damnitzhemanth-oss/Flight_Controller/images/DRAFT/S1_1.png

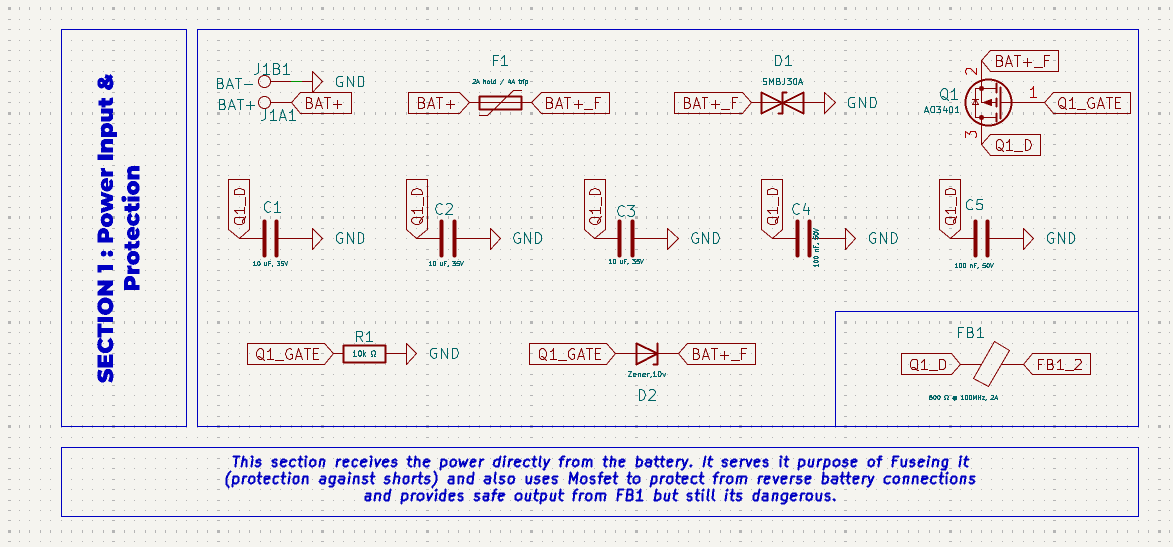
images/DRAFT/S1_1.png
