damnitzhemanth-oss/Flight_Controller/images/DRAFT/S2_1.png

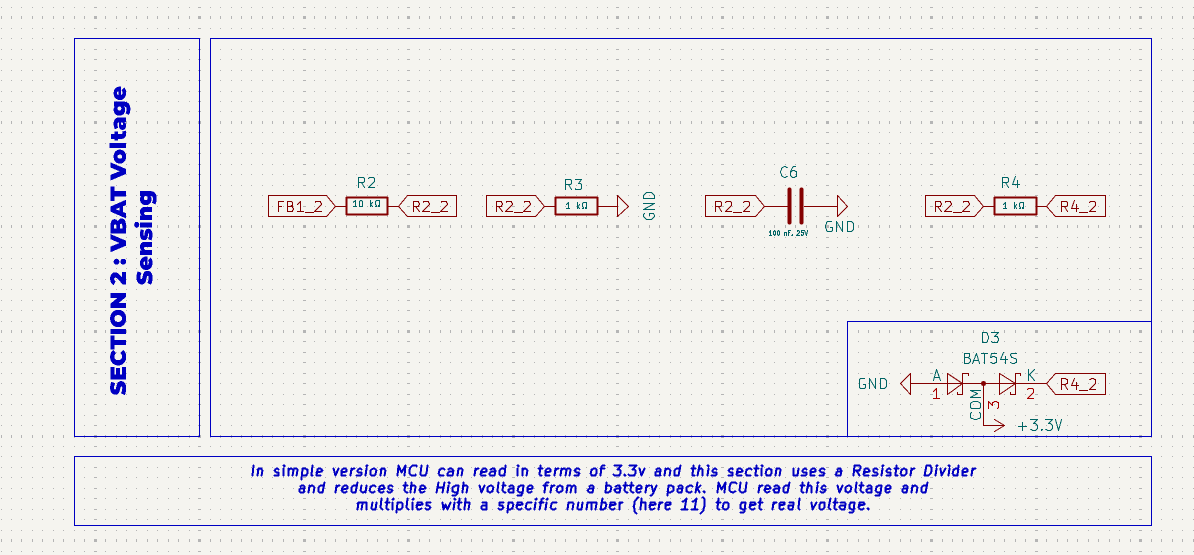
images/DRAFT/S2_1.png
