damnitzhemanth-oss/Flight_Controller/images/DRAFT/S3_1.png

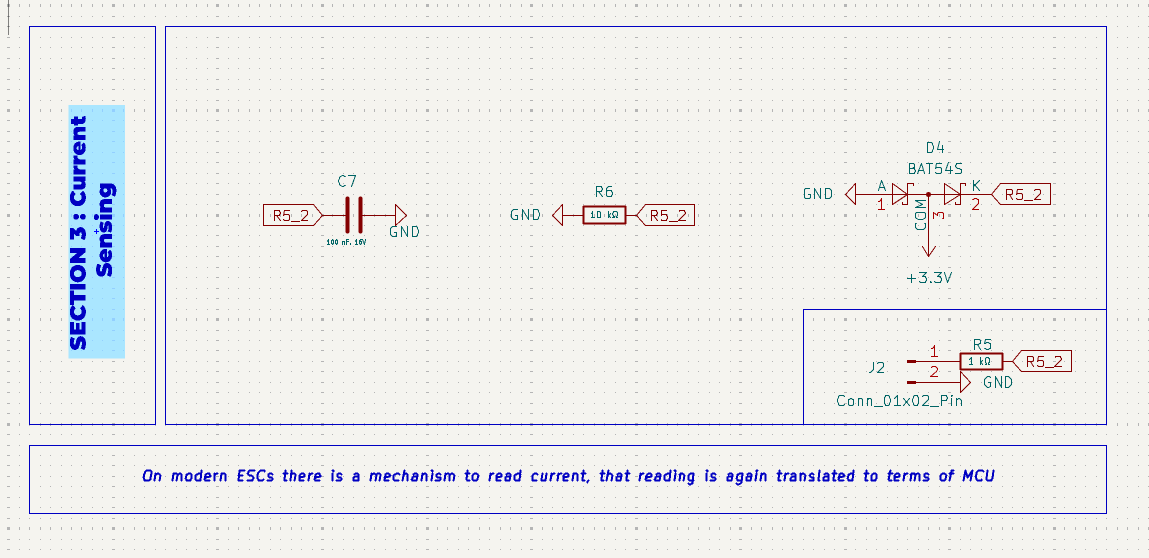
images/DRAFT/S3_1.png
