damnitzhemanth-oss/Flight_Controller/images/DRAFT/S4_2.png

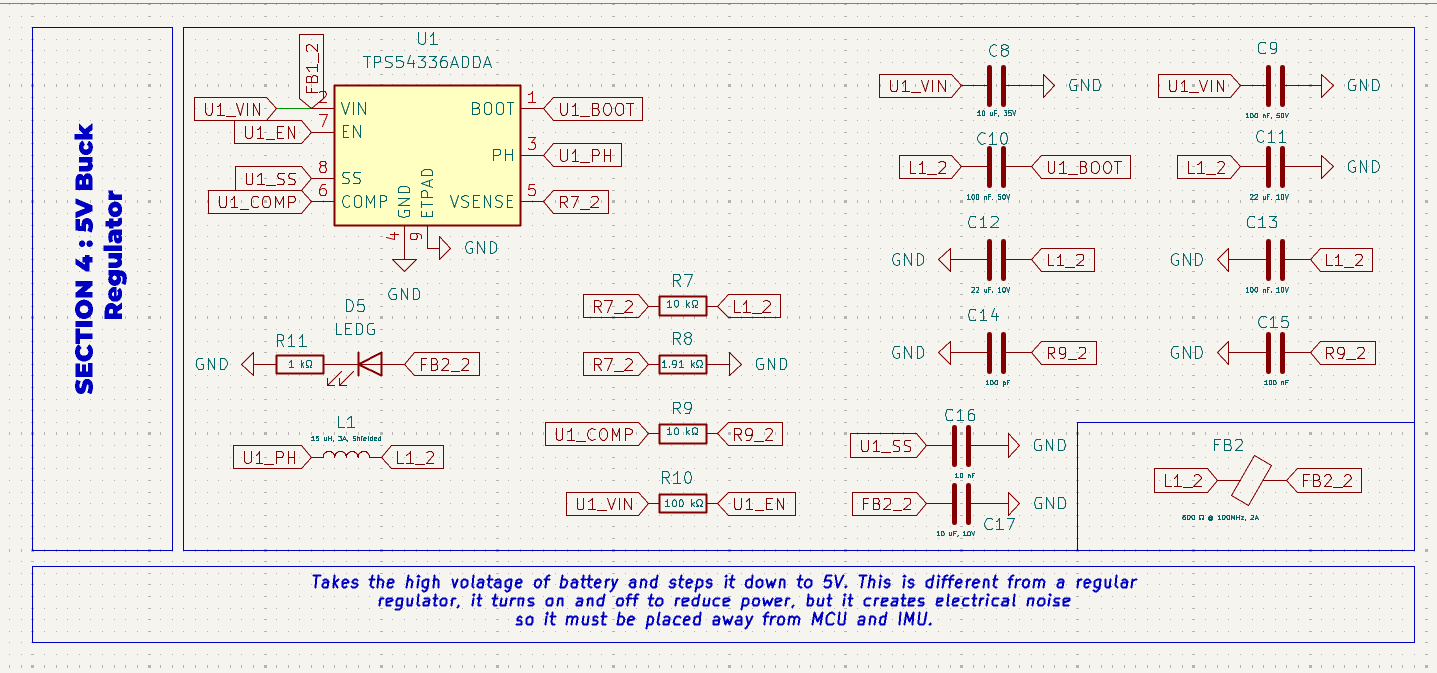
images/DRAFT/S4_2.png
