damnitzhemanth-oss/Flight_Controller/images/DRAFT/S4_P.png

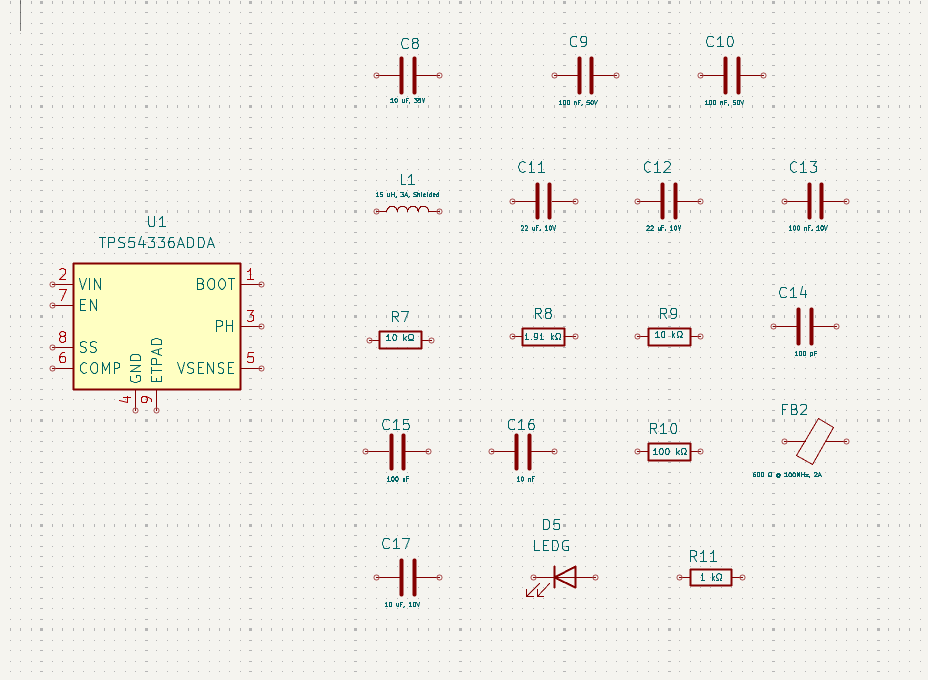
images/DRAFT/S4_P.png
