damnitzhemanth-oss/Flight_Controller/images/DRAFT/S5_2.png

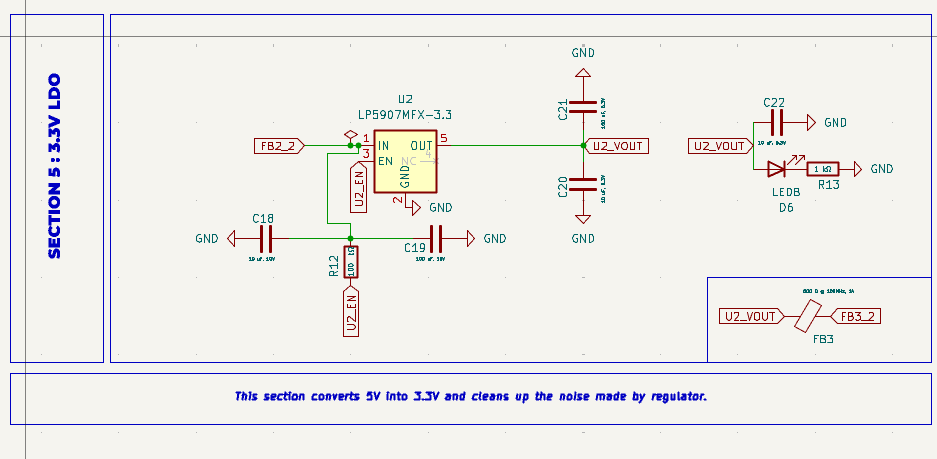
images/DRAFT/S5_2.png
