damnitzhemanth-oss/Flight_Controller/images/DRAFT/S6_2.png

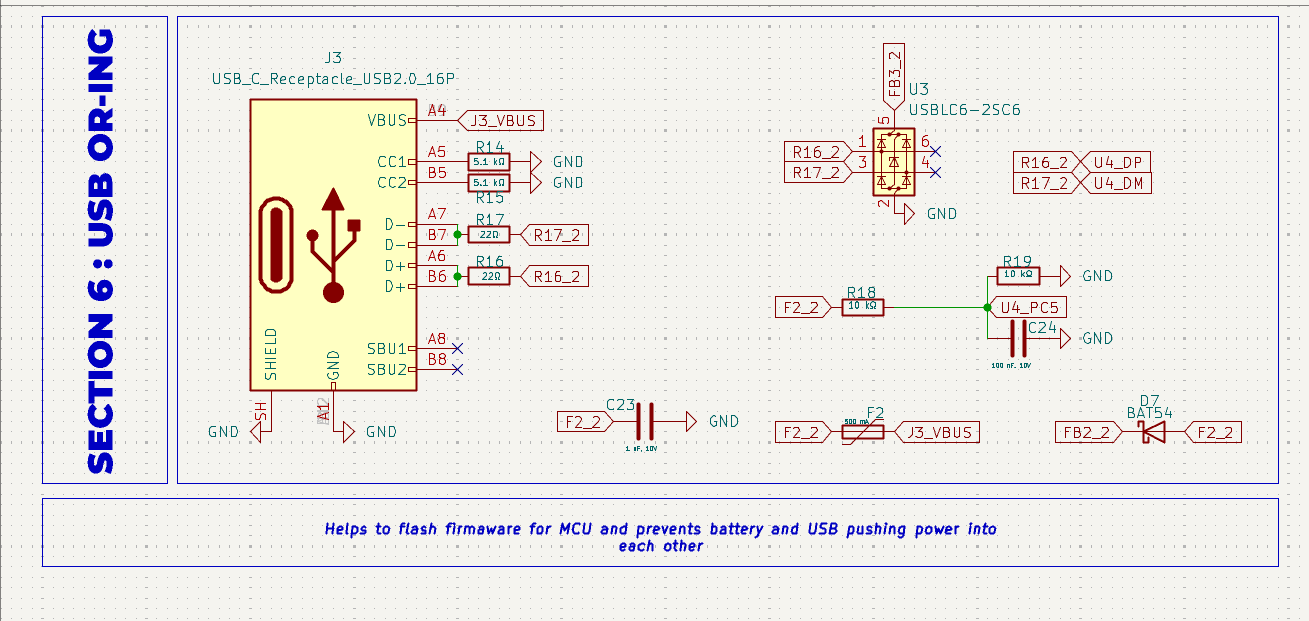
images/DRAFT/S6_2.png
