damnitzhemanth-oss/Flight_Controller/images/DRAFT/S7_2.png

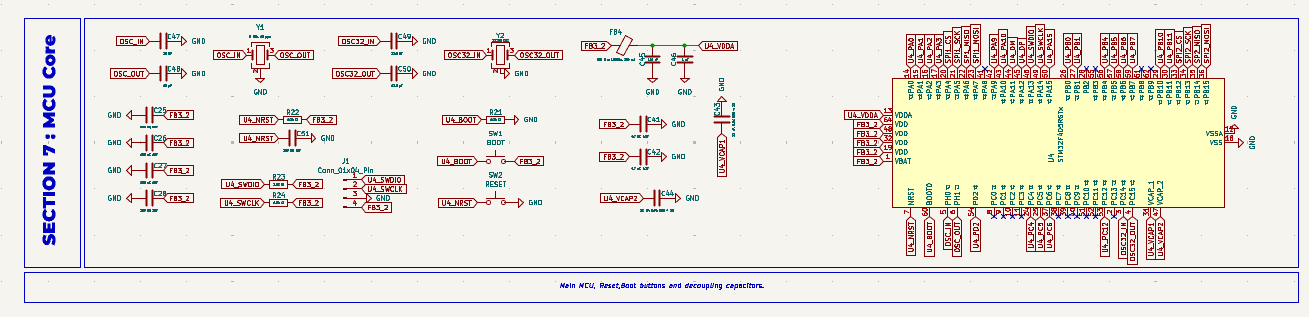
images/DRAFT/S7_2.png
