damnitzhemanth-oss/Flight_Controller/images/DRAFT/S8_2.png

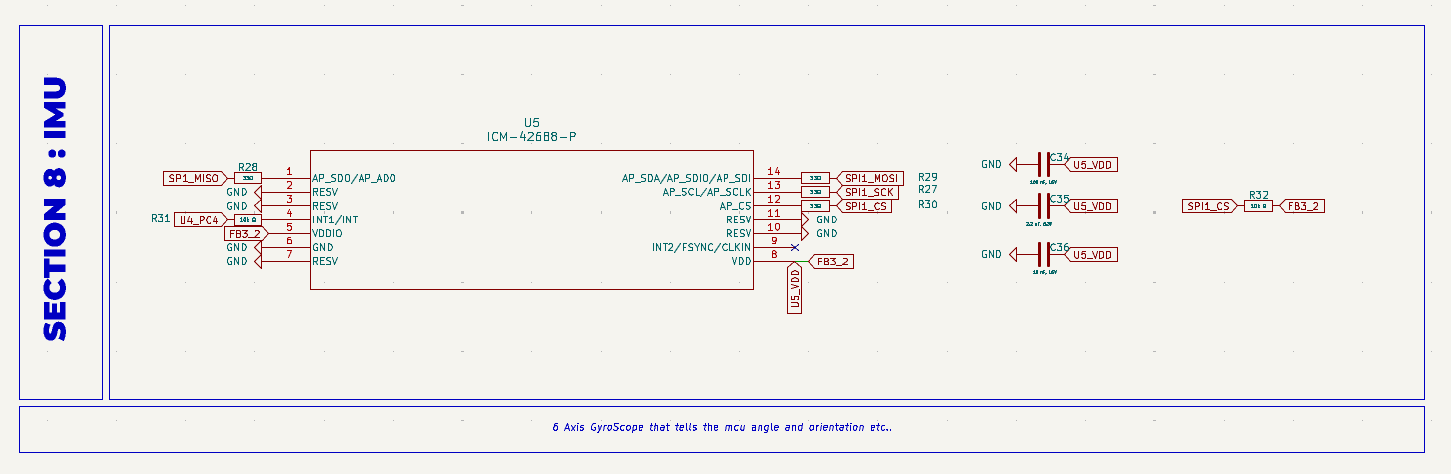
images/DRAFT/S8_2.png
