damnitzhemanth-oss/Flight_Controller/images/DRAFT/S9_2.png

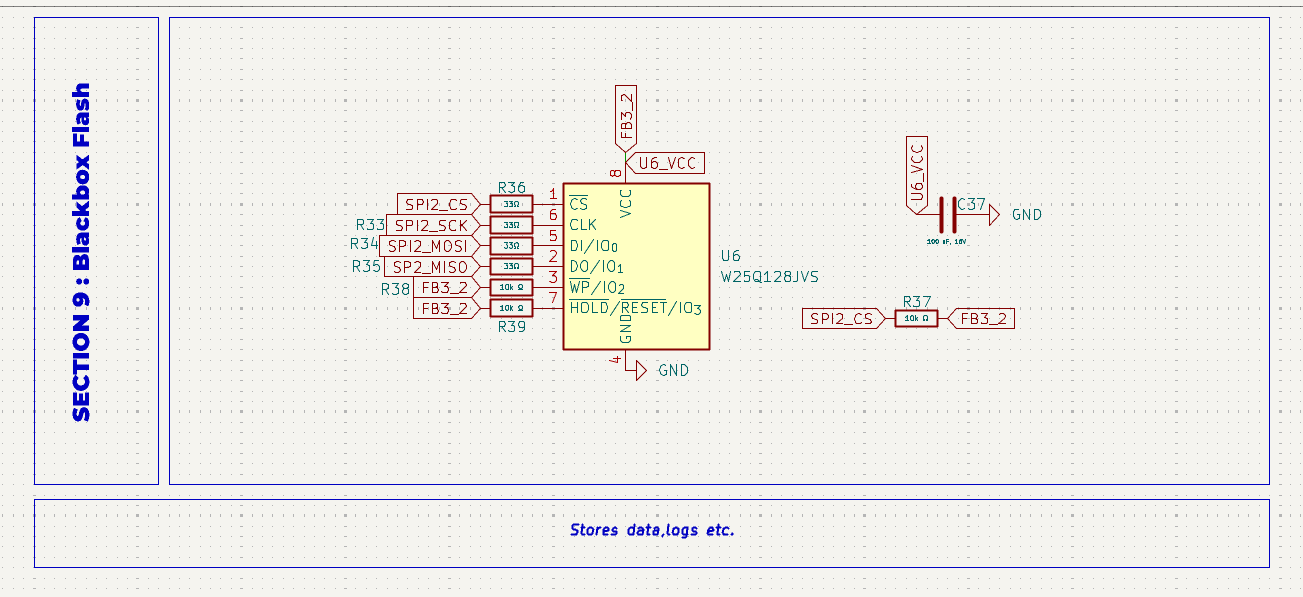
images/DRAFT/S9_2.png
