damnitzhemanth-oss/Flight_Controller/images/DRAFT/S10_2.png

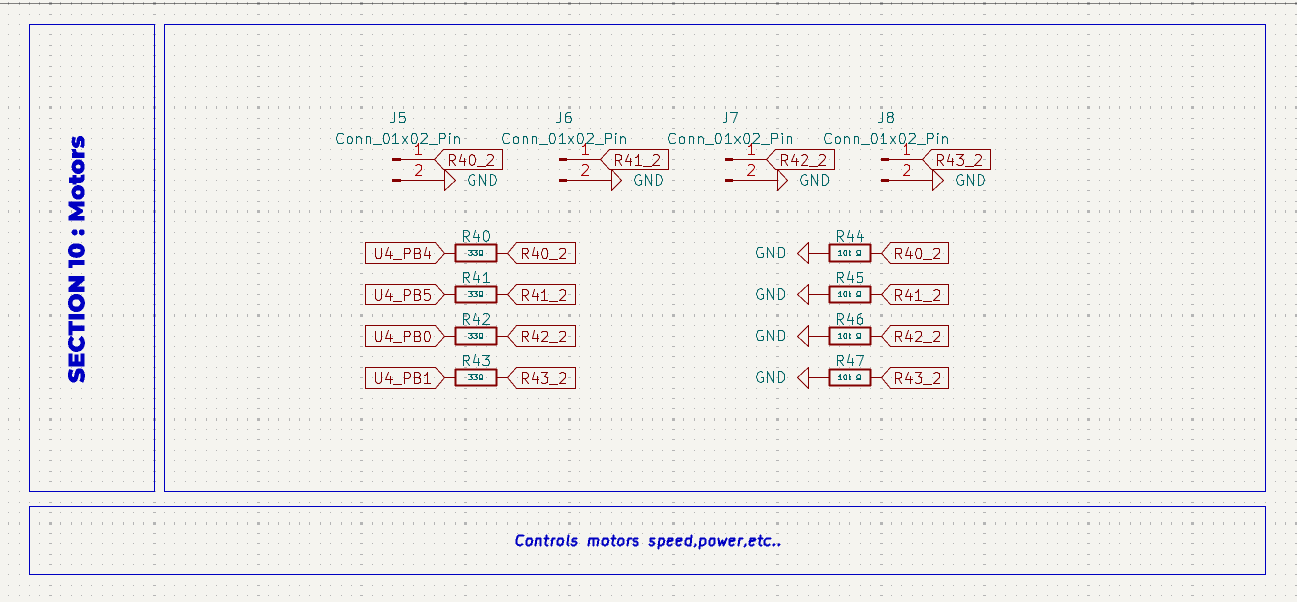
images/DRAFT/S10_2.png
