damnitzhemanth-oss/Flight_Controller/images/DRAFT/S11_2.png

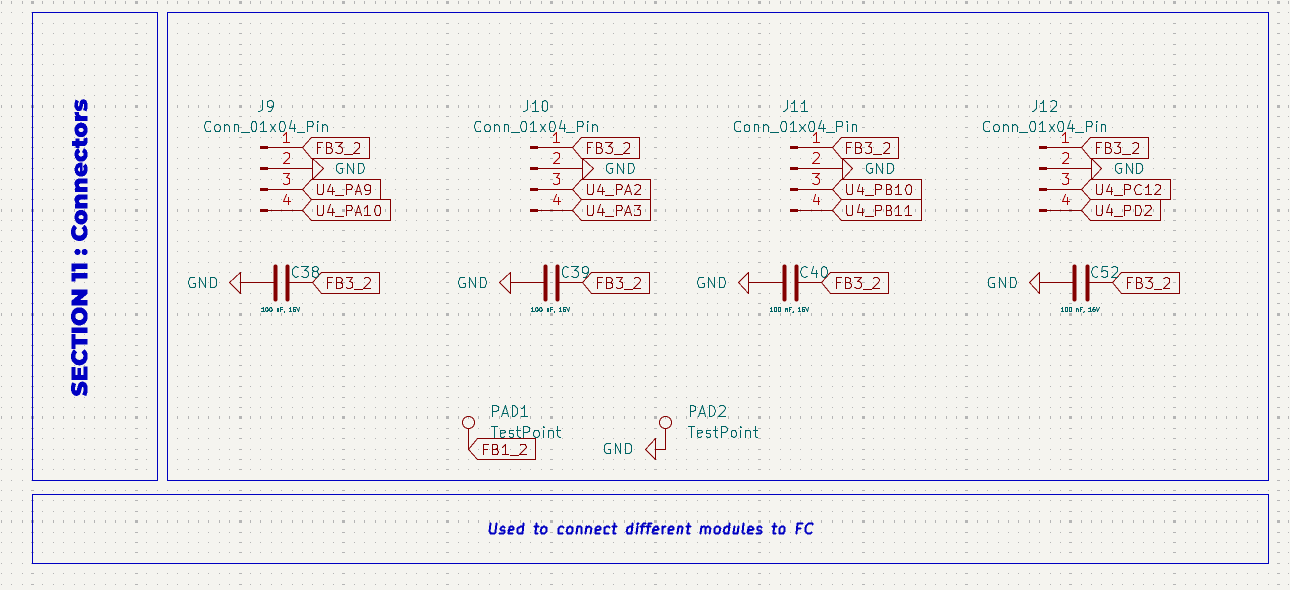
images/DRAFT/S11_2.png
