damnitzhemanth-oss/Flight_Controller/images/DRAFT/S12_2.png

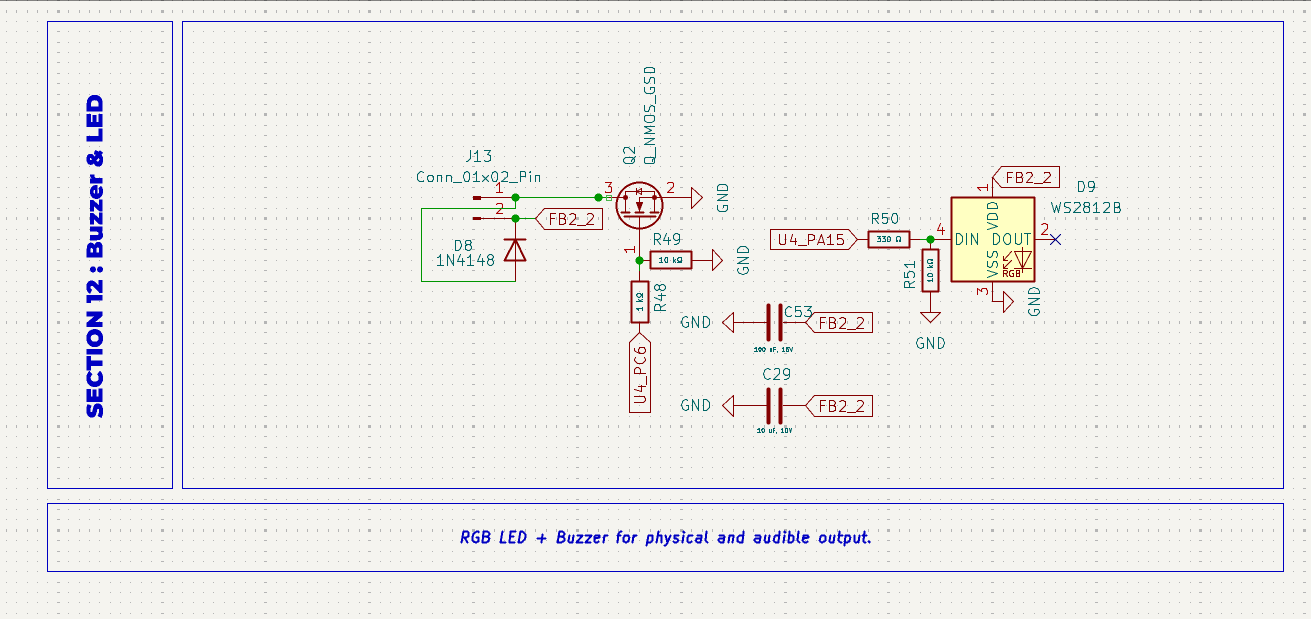
images/DRAFT/S12_2.png
