damnitzhemanth-oss/Flight_Controller/images/DRAFT/S13_2.png

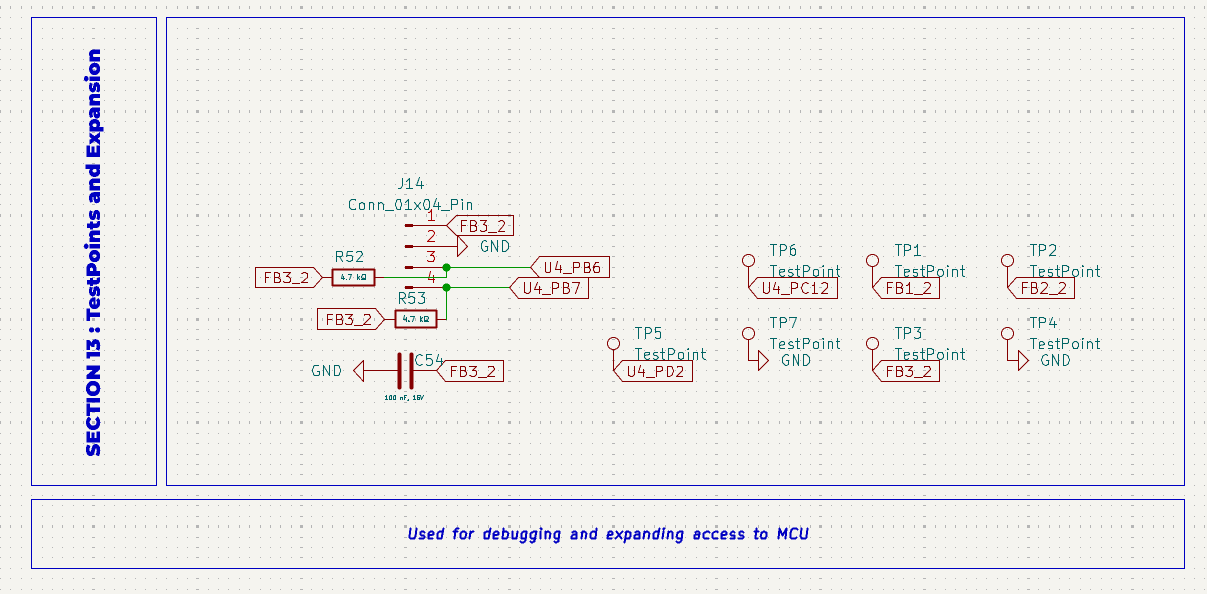
images/DRAFT/S13_2.png
