damnitzhemanth-oss/Flight_Controller/images/DRAFT/SFull_2.png

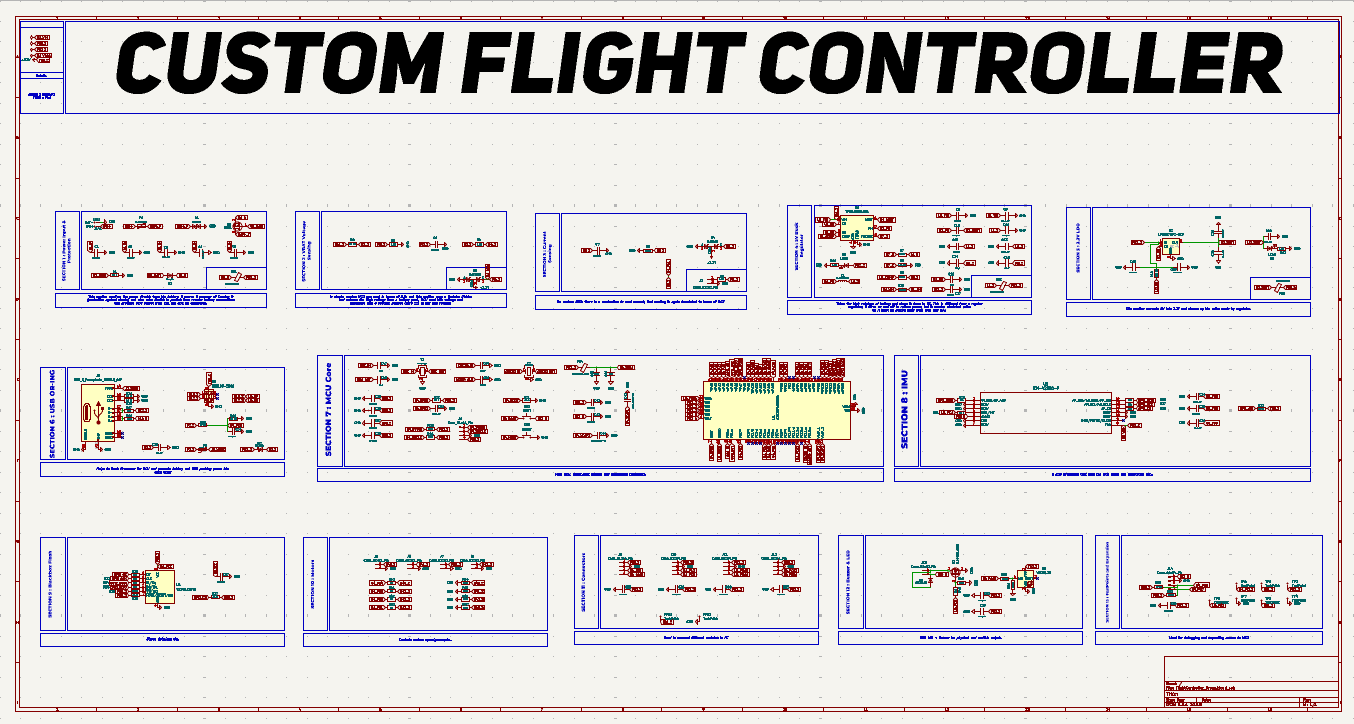
images/DRAFT/SFull_2.png
