damnitzhemanth-oss/Flight_Controller/images/FINAL/DRC_DUMB.png

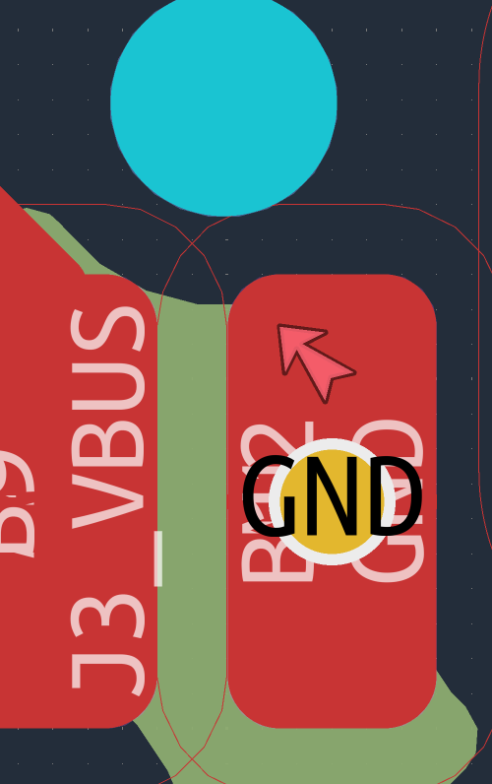
images/FINAL/DRC_DUMB.png
