damnitzhemanth-oss/Flight_Controller/images/FINAL/F_PCB.png

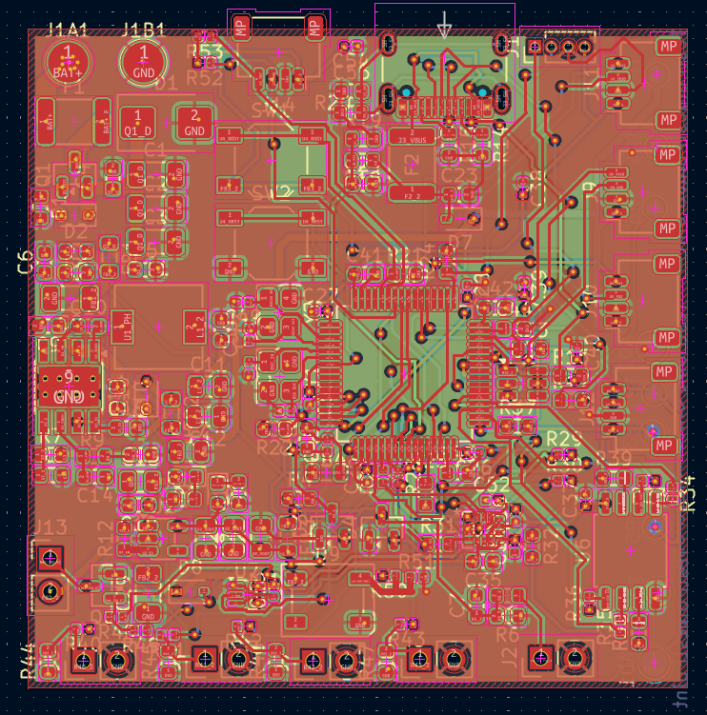
images/FINAL/F_PCB.png
