damnitzhemanth-oss/Flight_Controller/images/FINAL/In1_CU.png

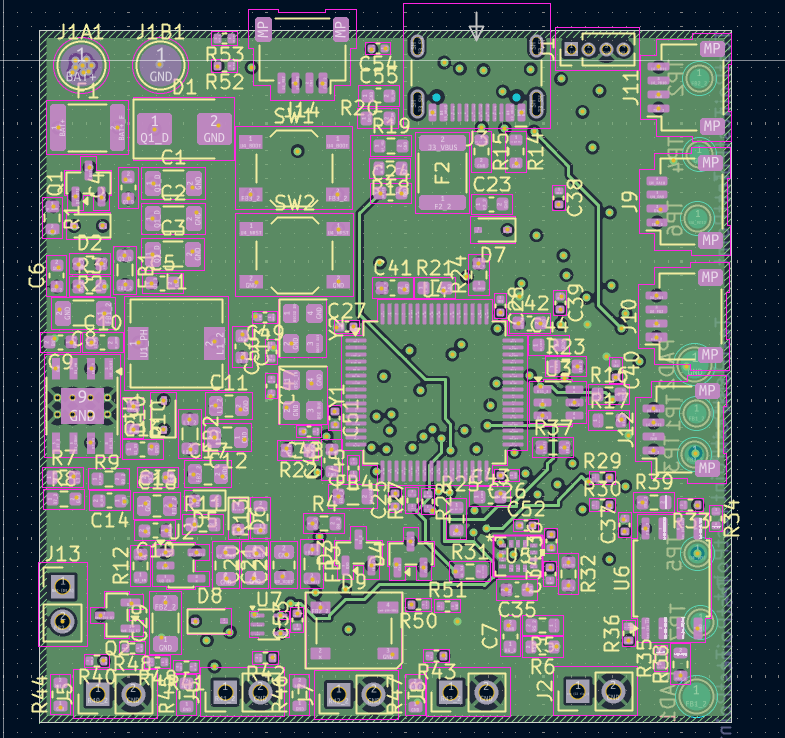
images/FINAL/In1_CU.png
