damnitzhemanth-oss/Flight_Controller/images/FINAL/In2_CU.png

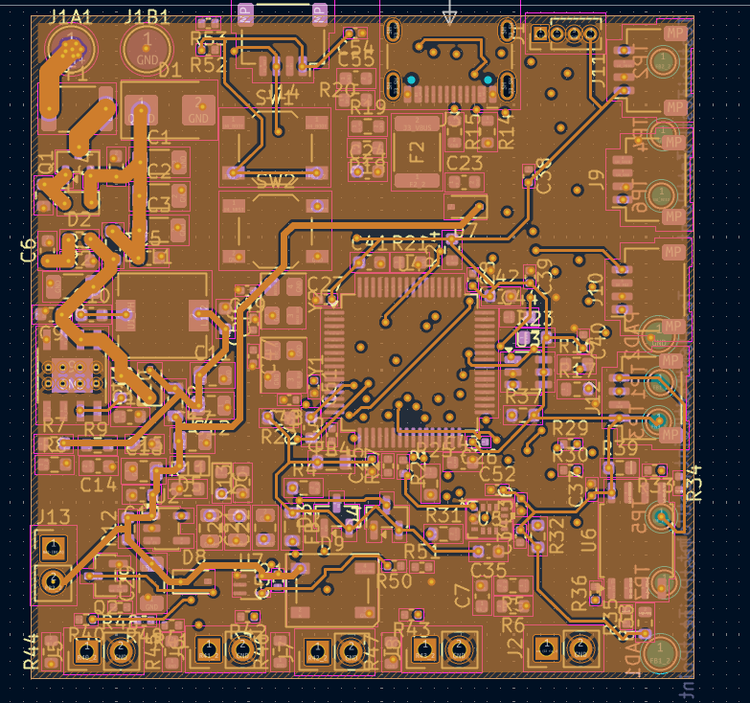
images/FINAL/In2_CU.png
