damnitzhemanth-oss/Flight_Controller/images/FINAL/S1.png

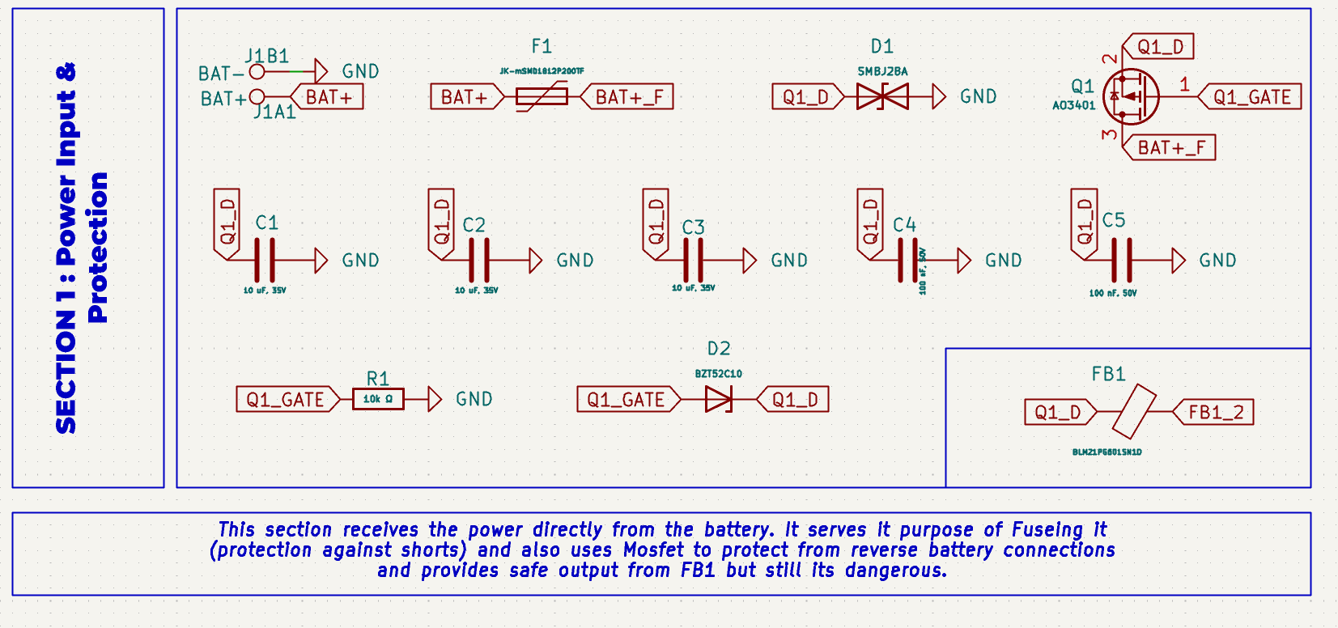
images/FINAL/S1.png
