damnitzhemanth-oss/Flight_Controller/images/FINAL/S2.png

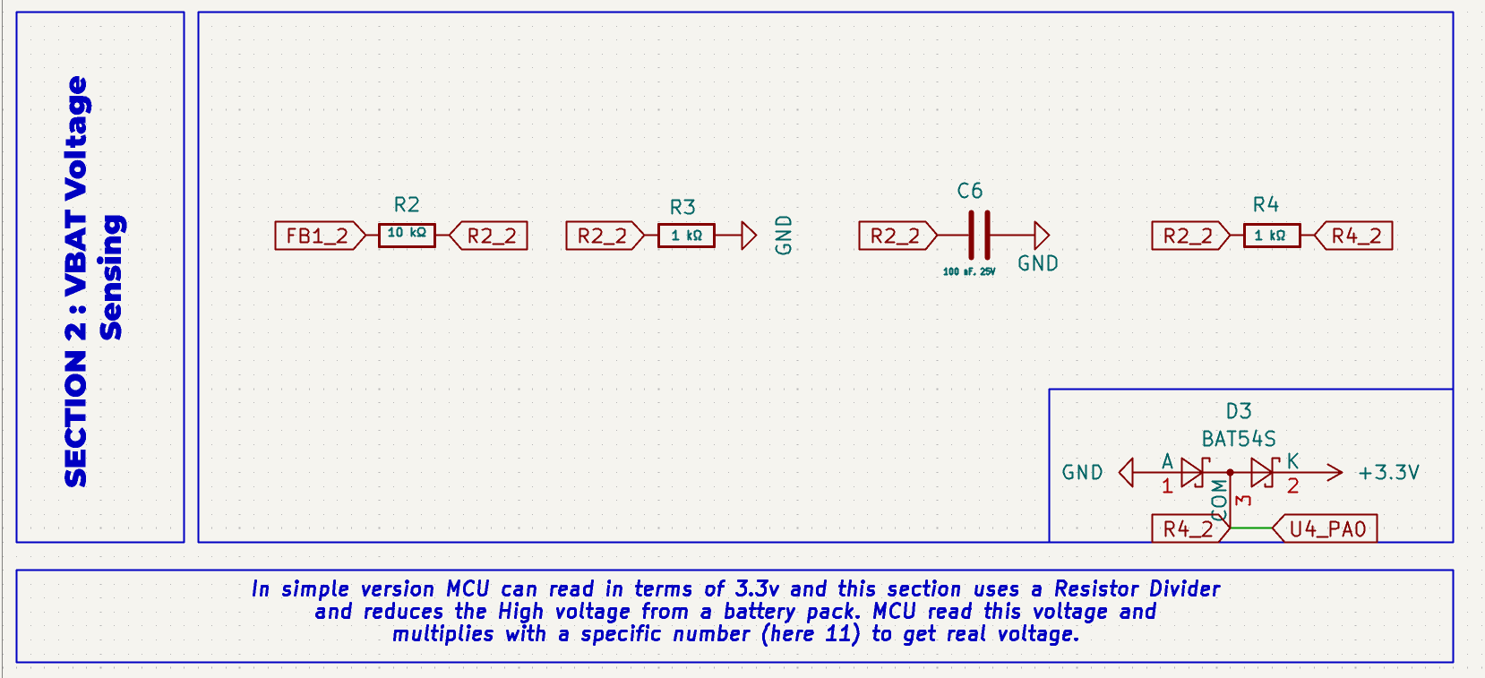
images/FINAL/S2.png
