damnitzhemanth-oss/Flight_Controller/images/FINAL/S3.png

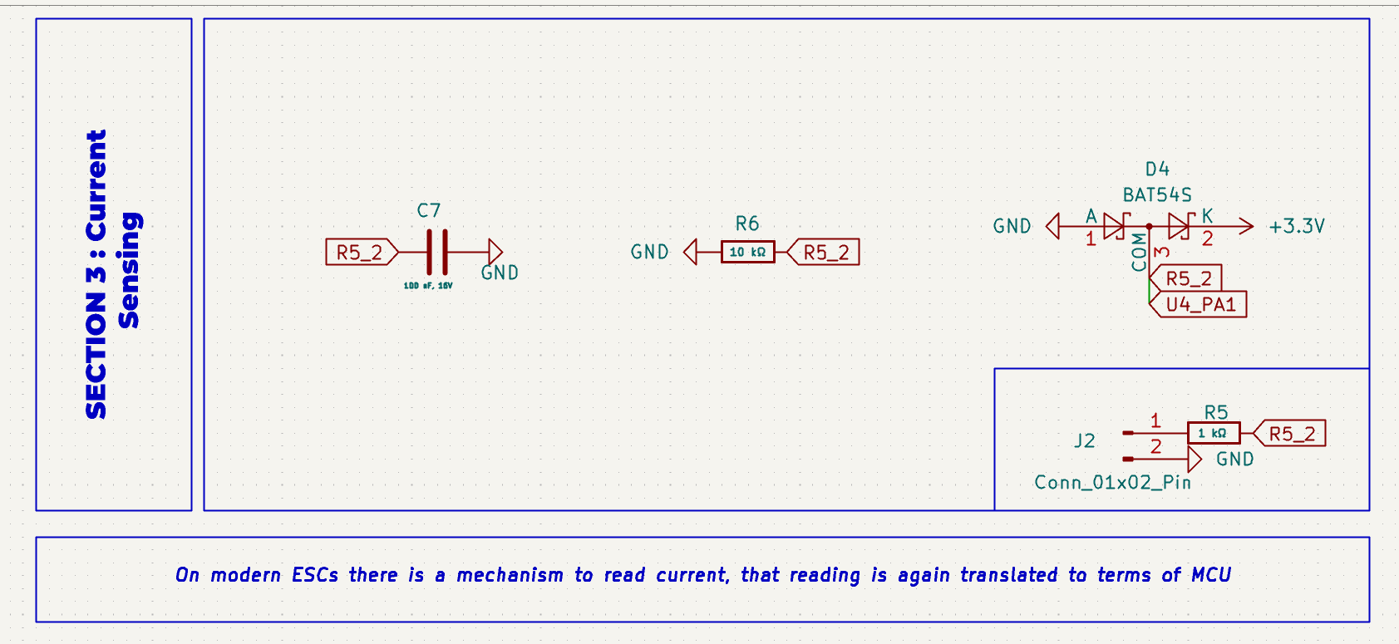
images/FINAL/S3.png
