damnitzhemanth-oss/Flight_Controller/images/FINAL/S4.png

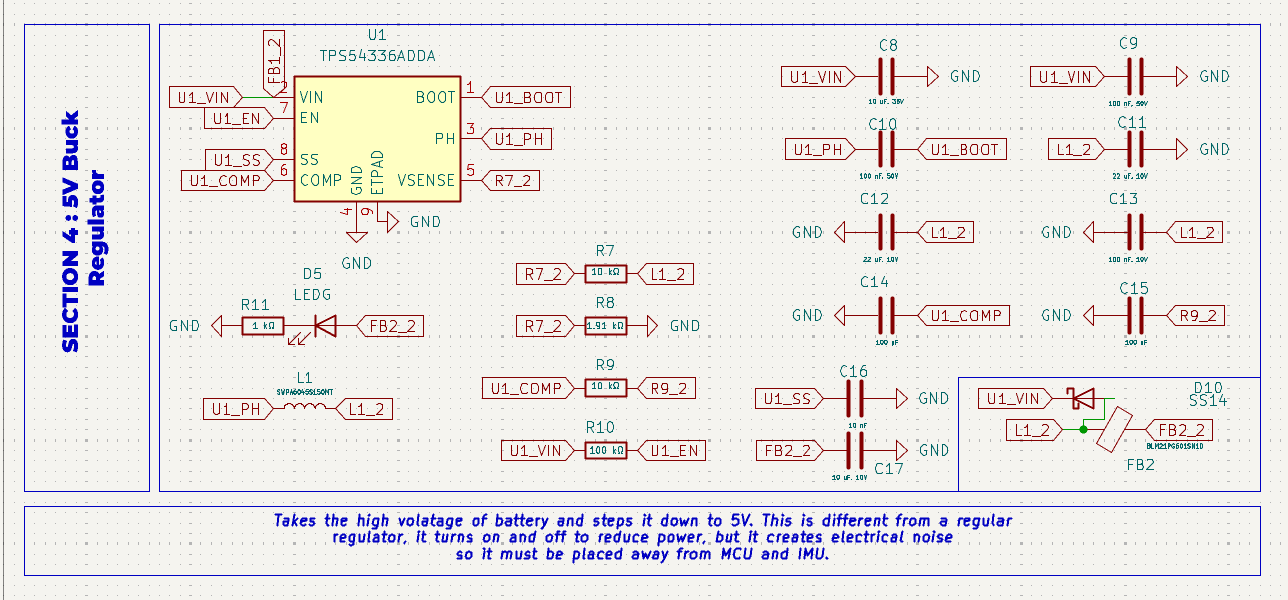
images/FINAL/S4.png
