damnitzhemanth-oss/Flight_Controller/images/FINAL/S5.png

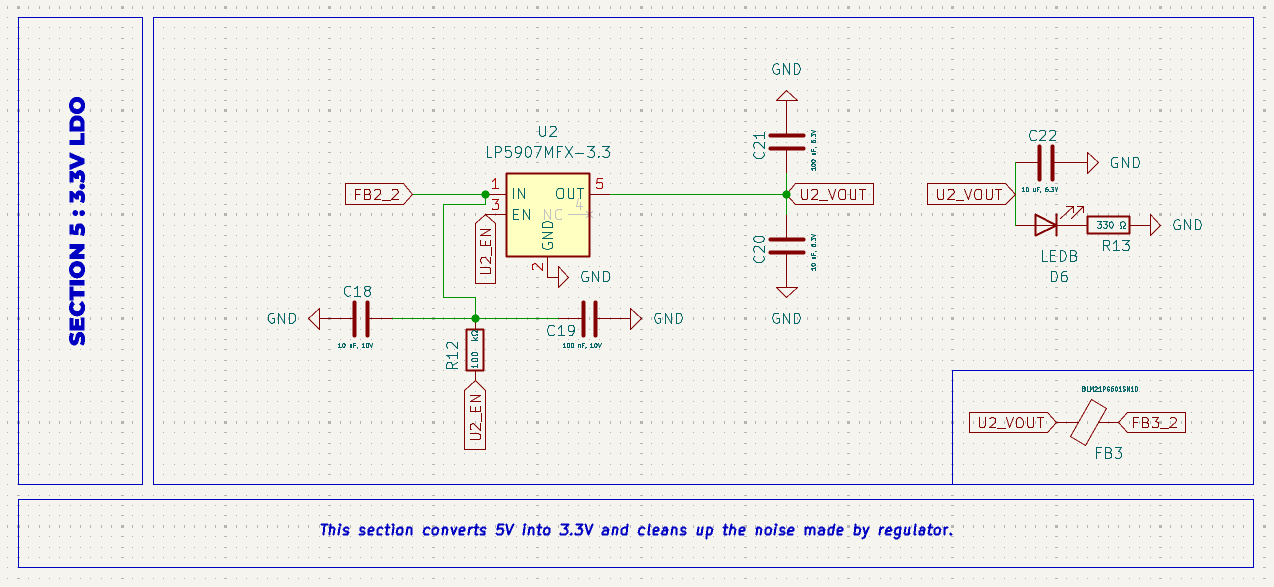
images/FINAL/S5.png
