damnitzhemanth-oss/Flight_Controller/images/FINAL/S6.png

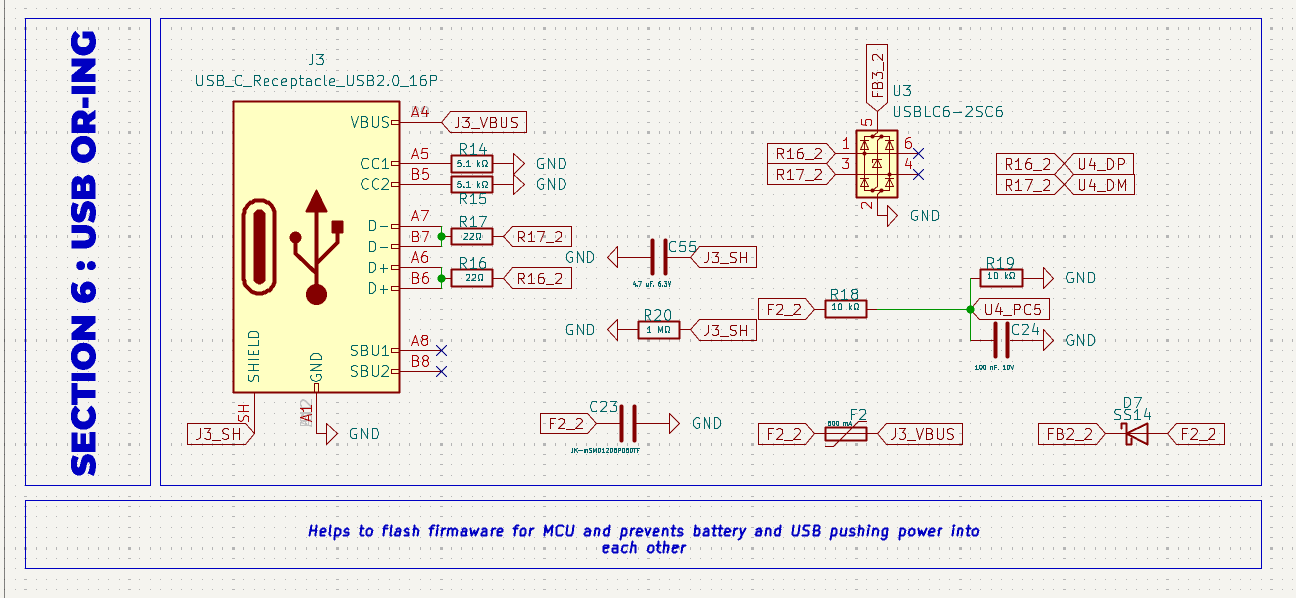
images/FINAL/S6.png
