damnitzhemanth-oss/Flight_Controller/images/FINAL/S7.png

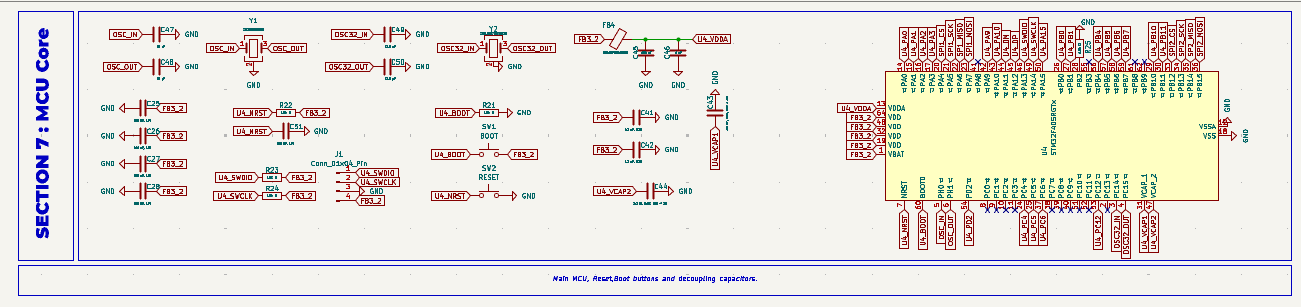
images/FINAL/S7.png
