damnitzhemanth-oss/Flight_Controller/images/FINAL/S8.png

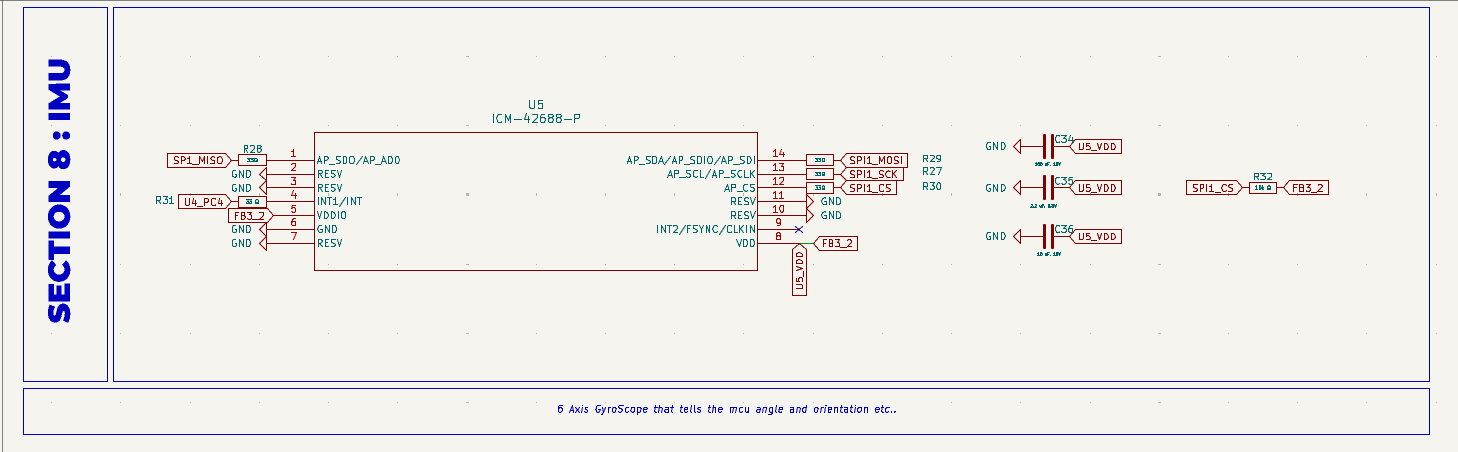
images/FINAL/S8.png
