damnitzhemanth-oss/Flight_Controller/images/FINAL/S10.png

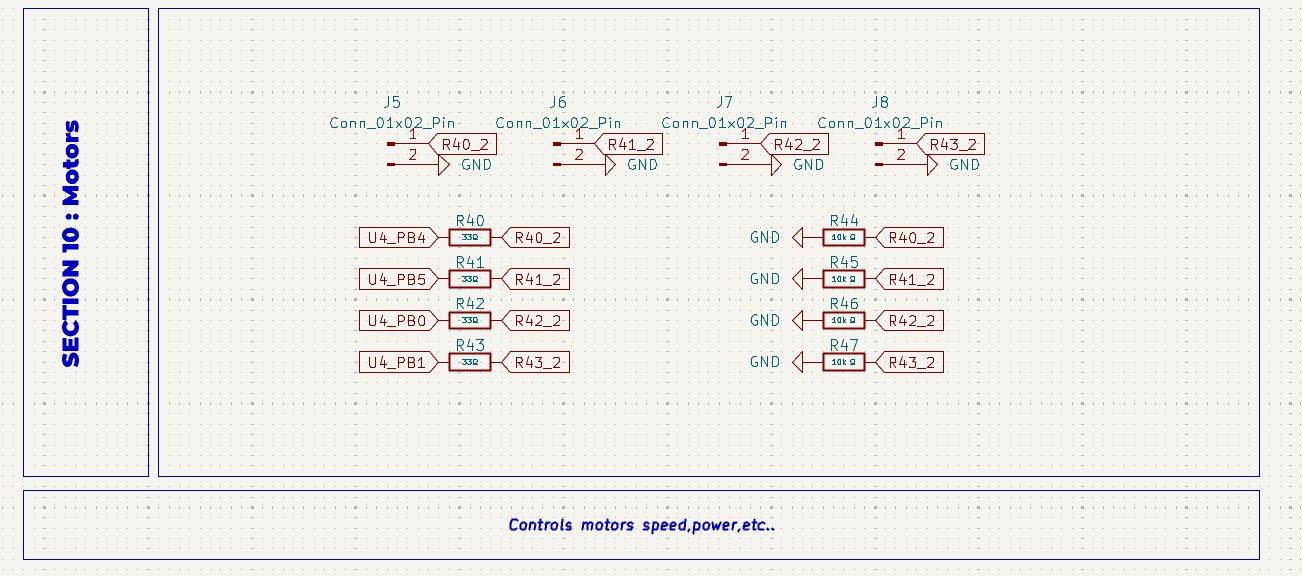
images/FINAL/S10.png
