damnitzhemanth-oss/Flight_Controller/images/FINAL/S11.png

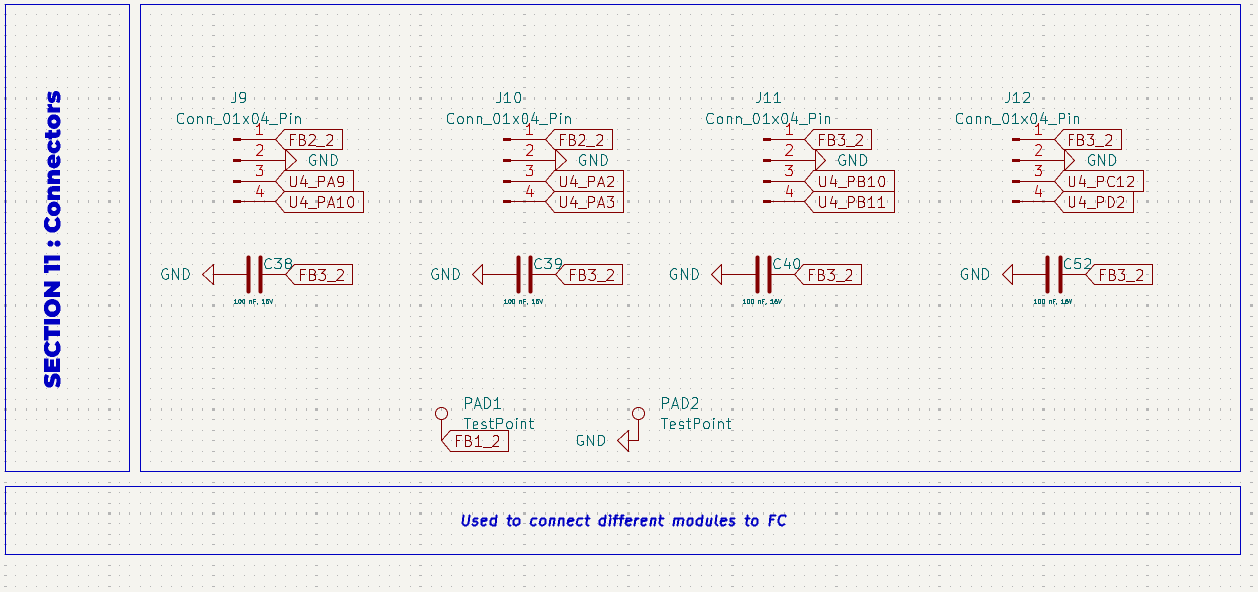
images/FINAL/S11.png
