damnitzhemanth-oss/Flight_Controller/images/FINAL/S12.png

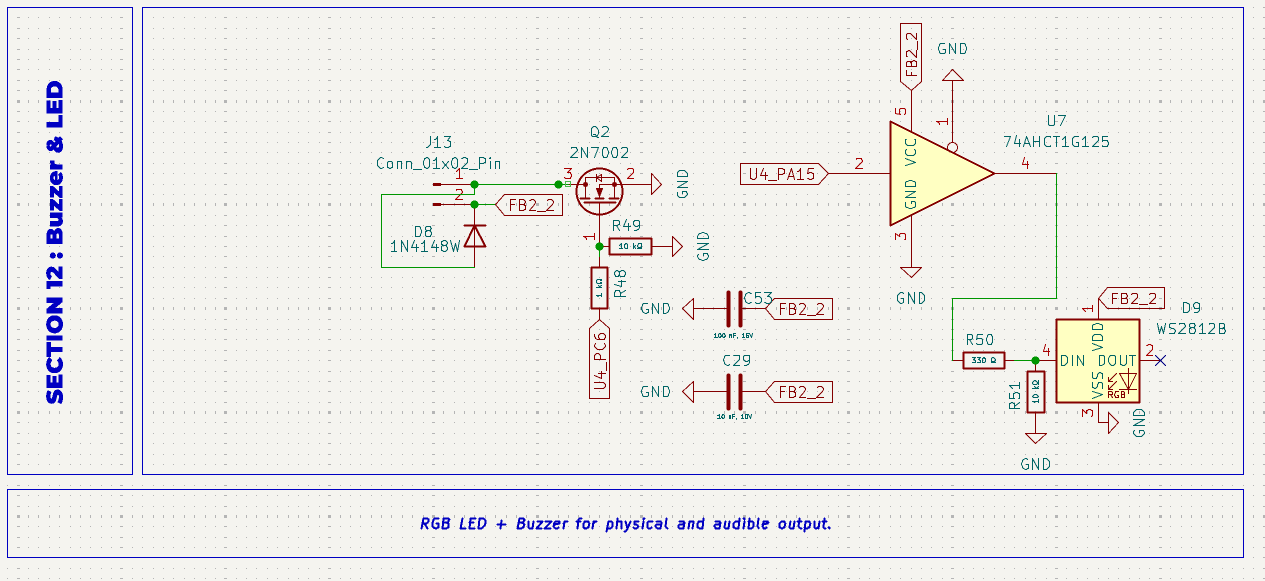
images/FINAL/S12.png
