damnitzhemanth-oss/Flight_Controller/images/FINAL/S13.png

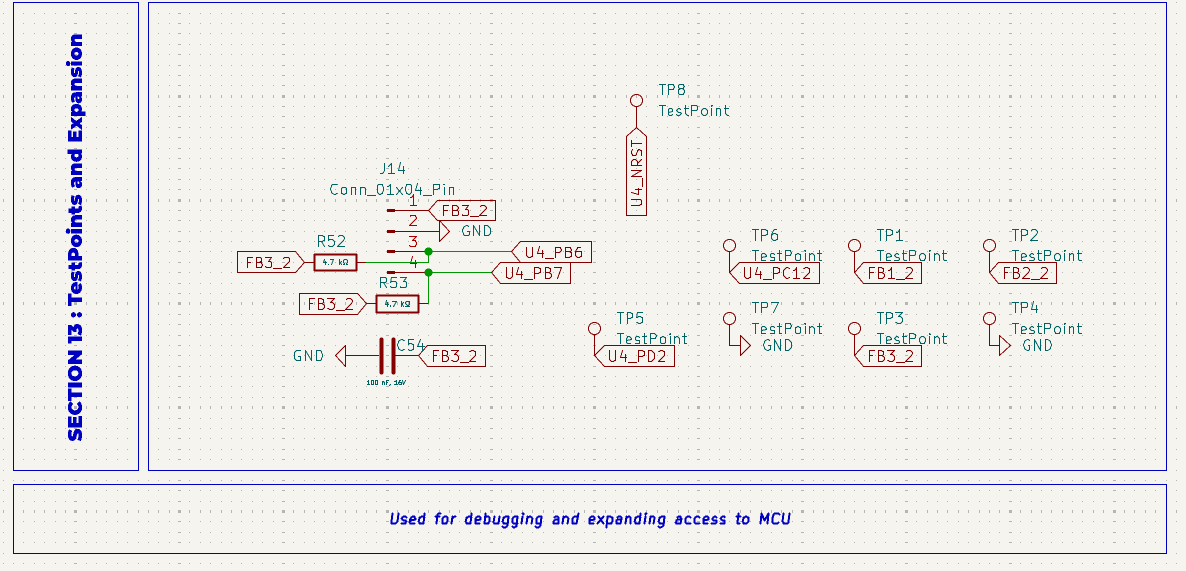
images/FINAL/S13.png
