damnitzhemanth-oss/Flight_Controller/PCB/FlightController_Drone.csv

Reference | Qty | Value | DNP | Exclude from BOM | Exclude from Board | Exclude from Simulation | Exclude from Position Files | Footprint | Datasheet
C1,C2,C3,C8 | 4 | 10 uF, 35V |  |  |  |  | ${EXCLUDE_FROM_POS_FILES} | Capacitor_SMD:C_1206_3216Metric
C4,C5,C9,C10 | 4 | 100 nF, 50V |  |  |  |  | ${EXCLUDE_FROM_POS_FILES} | Capacitor_SMD:C_0603_1608Metric
C6 | 1 | 100 nF, 25V |  |  |  |  | ${EXCLUDE_FROM_POS_FILES} | Capacitor_SMD:C_0603_1608Metric
C7 | 1 | 100 nF, 16V |  |  |  |  | ${EXCLUDE_FROM_POS_FILES} | Capacitor_SMD:C_0603_1608Metric
C11,C12 | 2 | 22 uF, 10V |  |  |  |  | ${EXCLUDE_FROM_POS_FILES} | Capacitor_SMD:C_0805_2012Metric
C13,C19,C24 | 3 | 100 nF, 10V |  |  |  |  | ${EXCLUDE_FROM_POS_FILES} | Capacitor_SMD:C_0603_1608Metric
C14 | 1 | 100 pF |  |  |  |  | ${EXCLUDE_FROM_POS_FILES} | Capacitor_SMD:C_0603_1608Metric
C15 | 1 | 100 nF |  |  |  |  | ${EXCLUDE_FROM_POS_FILES} | Capacitor_SMD:C_0603_1608Metric
C16 | 1 | 10 nF |  |  |  |  | ${EXCLUDE_FROM_POS_FILES} | Capacitor_SMD:C_0603_1608Metric
C17,C18 | 2 | 10 uF, 10V |  |  |  |  | ${EXCLUDE_FROM_POS_FILES} | Capacitor_SMD:C_0805_2012Metric
C20,C22 | 2 | 10 uF, 6.3V |  |  |  |  | ${EXCLUDE_FROM_POS_FILES} | Capacitor_SMD:C_0805_2012Metric
C21 | 1 | 100 nF, 6.3V |  |  |  |  | ${EXCLUDE_FROM_POS_FILES} | Capacitor_SMD:C_0805_2012Metric
C23 | 1 | JK-mSMD1206P050TF |  |  |  |  | ${EXCLUDE_FROM_POS_FILES} | Capacitor_SMD:C_0603_1608Metric
C25,C26,C27,C28,C34,C37,C38,C39,C40,C51,C52,C53,C54 | 13 | 100 nF, 16V |  |  |  |  | ${EXCLUDE_FROM_POS_FILES} | Capacitor_SMD:C_0402_1005Metric
C29 | 1 | 10 uF, 10V |  |  |  |  | ${EXCLUDE_FROM_POS_FILES} | Capacitor_SMD:C_1206_3216Metric
C35 | 1 | 2.2 uF, 6.3V |  |  |  |  | ${EXCLUDE_FROM_POS_FILES} | Capacitor_SMD:C_0603_1608Metric
C36 | 1 | 10 nF, 16V |  |  |  |  | ${EXCLUDE_FROM_POS_FILES} | Capacitor_SMD:C_0402_1005Metric
C41,C42,C55 | 3 | 4.7 uF, 6.3V |  |  |  |  | ${EXCLUDE_FROM_POS_FILES} | Capacitor_SMD:C_0603_1608Metric
C43,C44 | 2 | 2.2 uF, 6.3V, ESR < 2Ω |  |  |  |  | ${EXCLUDE_FROM_POS_FILES} | Capacitor_SMD:C_0603_1608Metric
C45 | 1 | 100 nF |  |  |  |  | ${EXCLUDE_FROM_POS_FILES} | Capacitor_SMD:C_0402_1005Metric
C46 | 1 | 1 uF |  |  |  |  | ${EXCLUDE_FROM_POS_FILES} | Capacitor_SMD:C_0603_1608Metric
C47,C48 | 2 | 18 pF |  |  |  |  | ${EXCLUDE_FROM_POS_FILES} | Capacitor_SMD:C_0402_1005Metric
C49,C50 | 2 | 12.5 pF |  |  |  |  | ${EXCLUDE_FROM_POS_FILES} | Capacitor_SMD:C_0402_1005Metric
D1 | 1 | SMBJ28A |  |  |  |  | ${EXCLUDE_FROM_POS_FILES} | Diode_SMD:D_SMB
D2 | 1 | BZT52C10 |  |  |  |  | ${EXCLUDE_FROM_POS_FILES} | Diode_SMD:D_SOD-323
D3,D4 | 2 | BAT54S |  |  |  |  | ${EXCLUDE_FROM_POS_FILES} | Package_TO_SOT_SMD:SOT-23 | https://www.diodes.com/assets/Datasheets/ds11005.pdf
D5 | 1 | LEDG |  |  |  |  | ${EXCLUDE_FROM_POS_FILES} | LED_SMD:LED_0603_1608Metric
D6 | 1 | LEDB |  |  |  |  | ${EXCLUDE_FROM_POS_FILES} | LED_SMD:LED_0603_1608Metric
D7,D10 | 2 | SS14 |  |  |  |  | ${EXCLUDE_FROM_POS_FILES} | Diode_SMD:D_SOD-323
D8 | 1 | 1N4148W |  |  |  |  | ${EXCLUDE_FROM_POS_FILES} | Diode_SMD:D_SOD-323
D9 | 1 | WS2812B |  |  |  |  | ${EXCLUDE_FROM_POS_FILES} | LED_SMD:LED_WS2812B_PLCC4_5.0x5.0mm_P3.2mm | https://cdn-shop.adafruit.com/datasheets/WS2812B.pdf
F1 | 1 | JK-mSMD1812P200TF |  |  |  |  | ${EXCLUDE_FROM_POS_FILES} | Fuse:Fuse_1812_4532Metric
F2 | 1 | 500 mA |  |  |  |  | ${EXCLUDE_FROM_POS_FILES} | Fuse:Fuse_1812_4532Metric
FB1,FB2,FB3 | 3 | BLM21PG601SN1D |  |  |  |  | ${EXCLUDE_FROM_POS_FILES} | Inductor_SMD:L_0805_2012Metric
FB4 | 1 | BLM18PG601SN1D |  |  |  |  | ${EXCLUDE_FROM_POS_FILES} | Inductor_SMD:L_0805_2012Metric
J1 | 1 | Conn_01x04_Pin |  |  |  |  | ${EXCLUDE_FROM_POS_FILES} | Connector_PinHeader_1.27mm:PinHeader_1x04_P1.27mm_Vertical
J1A1 | 1 | BAT+ |  |  |  |  | ${EXCLUDE_FROM_POS_FILES} | TestPoint:TestPoint_Pad_D3.0mm
J1B1 | 1 | BAT- |  |  |  |  | ${EXCLUDE_FROM_POS_FILES} | TestPoint:TestPoint_Pad_D3.0mm
J2,J5,J6,J7,J8,J13 | 6 | Conn_01x02_Pin |  |  |  |  | ${EXCLUDE_FROM_POS_FILES} | Connector_PinHeader_2.54mm:PinHeader_1x02_P2.54mm_Vertical
J3 | 1 | USB_C_Receptacle_USB2.0_16P |  |  |  |  | ${EXCLUDE_FROM_POS_FILES} | Connector_USB:USB_C_Receptacle_HCTL_HC-TYPE-C-16P-01A | https://www.usb.org/sites/default/files/documents/usb_type-c.zip
J9,J10,J11,J12,J14 | 5 | Conn_01x04_Pin |  |  |  |  | ${EXCLUDE_FROM_POS_FILES} | Connector_JST:JST_SH_SM04B-SRSS-TB_1x04-1MP_P1.00mm_Horizontal
L1 | 1 | SWPA6045S150MT |  |  |  |  | ${EXCLUDE_FROM_POS_FILES} | Inductor_SMD:L_6.3x6.3_H3
PAD1,PAD2 | 2 | TestPoint |  |  |  |  | ${EXCLUDE_FROM_POS_FILES} | TestPoint:TestPoint_Pad_D2.0mm
Q1 | 1 | AO3401 |  |  |  |  | ${EXCLUDE_FROM_POS_FILES} | Package_TO_SOT_SMD:SOT-23
Q2 | 1 | 2N7002 |  |  |  |  | ${EXCLUDE_FROM_POS_FILES} | Package_TO_SOT_SMD:SOT-23
R1,R21,R22,R23,R24,R25,R32,R37,R38,R39,R44,R45,R46,R47 | 14 | 10k Ω |  |  |  |  | ${EXCLUDE_FROM_POS_FILES} | Resistor_SMD:R_0603_1608Metric
R2,R6,R7,R9,R18,R19 | 6 | 10 kΩ |  |  |  |  | ${EXCLUDE_FROM_POS_FILES} | Resistor_SMD:R_0603_1608Metric
R3,R4,R5,R11 | 4 | 1 kΩ |  |  |  |  | ${EXCLUDE_FROM_POS_FILES} | Resistor_SMD:R_0603_1608Metric
R8 | 1 | 1.91 kΩ |  |  |  |  | ${EXCLUDE_FROM_POS_FILES} | Resistor_SMD:R_0603_1608Metric
R10 | 1 | 100 kΩ |  |  |  |  | ${EXCLUDE_FROM_POS_FILES} | Resistor_SMD:R_0603_1608Metric
R12 | 1 | 100 kΩ |  |  |  |  | ${EXCLUDE_FROM_POS_FILES} | Resistor_SMD:R_0603_1608Metric
R13 | 1 | 330 Ω |  |  |  |  | ${EXCLUDE_FROM_POS_FILES} | Resistor_SMD:R_0603_1608Metric
R14,R15 | 2 | 5.1 kΩ |  |  |  |  | ${EXCLUDE_FROM_POS_FILES} | Resistor_SMD:R_0603_1608Metric
R16,R17 | 2 | 22Ω |  |  |  |  | ${EXCLUDE_FROM_POS_FILES} | Resistor_SMD:R_0603_1608Metric
R20 | 1 | 1 MΩ |  |  |  |  | ${EXCLUDE_FROM_POS_FILES} | Resistor_SMD:R_0603_1608Metric
R27,R28,R29,R30,R33,R34,R35,R36,R40,R41,R42,R43 | 12 | 33Ω |  |  |  |  | ${EXCLUDE_FROM_POS_FILES} | Resistor_SMD:R_0402_1005Metric
R31 | 1 | 33 Ω |  |  |  |  | ${EXCLUDE_FROM_POS_FILES} | Resistor_SMD:R_0603_1608Metric
R48 | 1 | 1 kΩ |  |  |  |  | ${EXCLUDE_FROM_POS_FILES} | Resistor_SMD:R_0402_1005Metric
R49,R51 | 2 | 10 kΩ |  |  |  |  | ${EXCLUDE_FROM_POS_FILES} | Resistor_SMD:R_0402_1005Metric
R50 | 1 | 330 Ω |  |  |  |  | ${EXCLUDE_FROM_POS_FILES} | Resistor_SMD:R_0402_1005Metric
R52,R53 | 2 | 4.7 kΩ |  |  |  |  | ${EXCLUDE_FROM_POS_FILES} | Resistor_SMD:R_0402_1005Metric
SW1 | 1 | BOOT |  |  |  |  | ${EXCLUDE_FROM_POS_FILES} | Button_Switch_SMD:SW_SPST_TL3342
SW2 | 1 | RESET |  |  |  |  | ${EXCLUDE_FROM_POS_FILES} | Button_Switch_SMD:SW_SPST_TL3342
TP1,TP2,TP3,TP4,TP5,TP6,TP7,TP8 | 8 | TestPoint |  |  |  |  | ${EXCLUDE_FROM_POS_FILES} | TestPoint:TestPoint_Pad_D1.5mm
U1 | 1 | TPS54336ADDA |  |  |  |  | ${EXCLUDE_FROM_POS_FILES} | Package_SO:TI_SO-PowerPAD-8_ThermalVias | http://www.ti.com/lit/ds/symlink/tps54336a.pdf
U2 | 1 | LP5907MFX-3.3 |  |  |  |  | ${EXCLUDE_FROM_POS_FILES} | Package_TO_SOT_SMD:SOT-23-5 | http://www.ti.com/lit/ds/symlink/lp5907.pdf
U3 | 1 | USBLC6-2SC6 |  |  |  |  | ${EXCLUDE_FROM_POS_FILES} | Package_TO_SOT_SMD:SOT-23-6 | https://www.st.com/resource/en/datasheet/usblc6-2.pdf
U4 | 1 | STM32F405RGTx |  |  |  |  | ${EXCLUDE_FROM_POS_FILES} | Package_QFP:LQFP-64_10x10mm_P0.5mm | https://www.st.com/resource/en/datasheet/stm32f405rg.pdf
U5 | 1 | ICM-42688-P |  |  |  |  | ${EXCLUDE_FROM_POS_FILES} | Custom_Footprints:LGA14_2P5X3X0P91_TDK | ICM-42688-P
U6 | 1 | W25Q128JVS |  |  |  |  | ${EXCLUDE_FROM_POS_FILES} | Package_SO:SOIC-8_5.3x5.3mm_P1.27mm | https://www.winbond.com/resource-files/w25q128jv_dtr%20revc%2003272018%20plus.pdf
U7 | 1 | 74AHCT1G125 |  |  |  |  | ${EXCLUDE_FROM_POS_FILES} | Package_TO_SOT_SMD:SOT-353_SC-70-5 | http://www.ti.com/lit/sg/scyt129e/scyt129e.pdf
Y1 | 1 | X32258MSB4SI |  |  |  |  | ${EXCLUDE_FROM_POS_FILES} | Crystal:Crystal_SMD_3225-4Pin_3.2x2.5mm
Y2 | 1 | X321532768KGD2SI |  |  |  |  | ${EXCLUDE_FROM_POS_FILES} | Crystal:Crystal_SMD_3225-4Pin_3.2x2.5mm
