damnitzhemanth-oss/Flight_Controller/PCB/CAD/FlightController_Drone.step

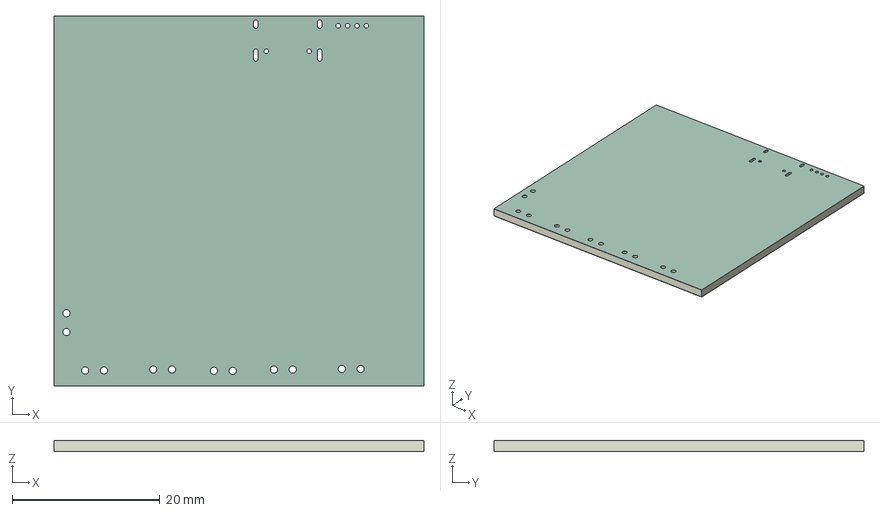
[picture p37: CAD file, 2026-10-13]
PCB/CAD/FlightController_Drone.step
50.0 x 50.0 x 1.57 mm
FlightController_Drone_soldermask x 2
FlightController_Drone_PCB
