damnitzhemanth-oss/Flight_Controller/PCB/FlightController_Drone.kicad_pcb

## KiCad design PCB/FlightController_Drone.kicad_pcb (2026-10-12)

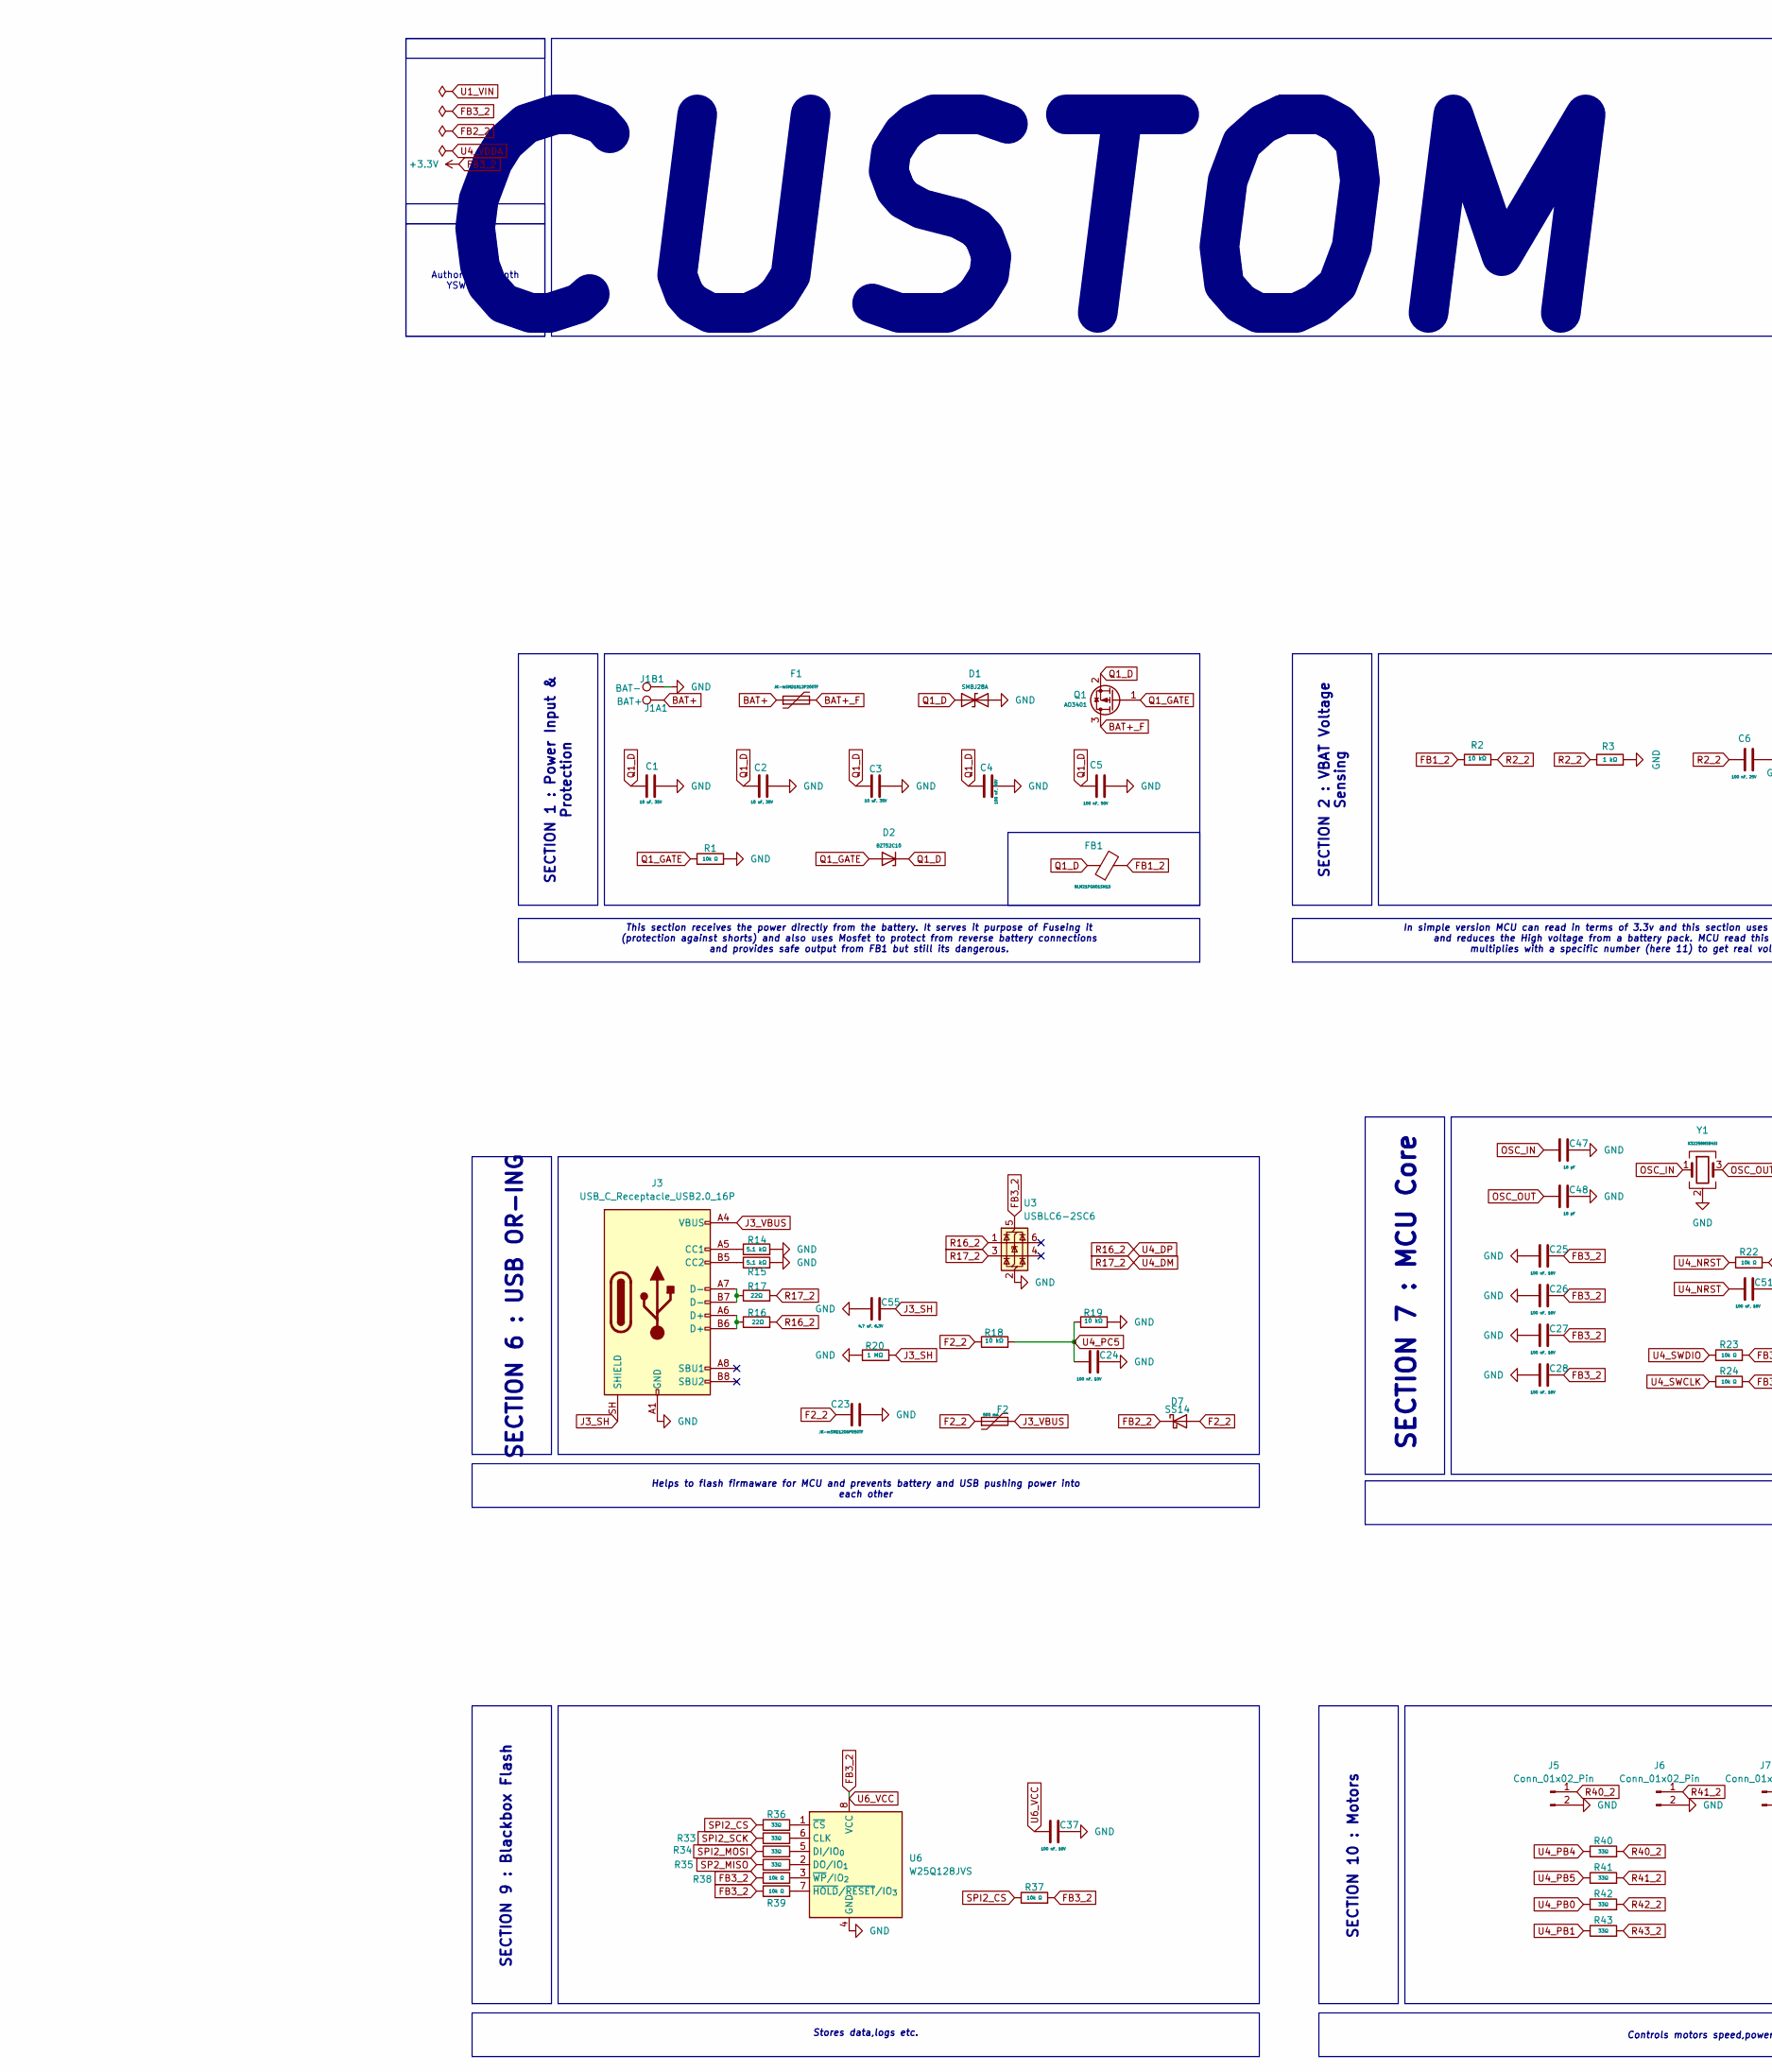
[picture p38: schematic FlightController_Drone.kicad_sch, part in row 1, column 1]

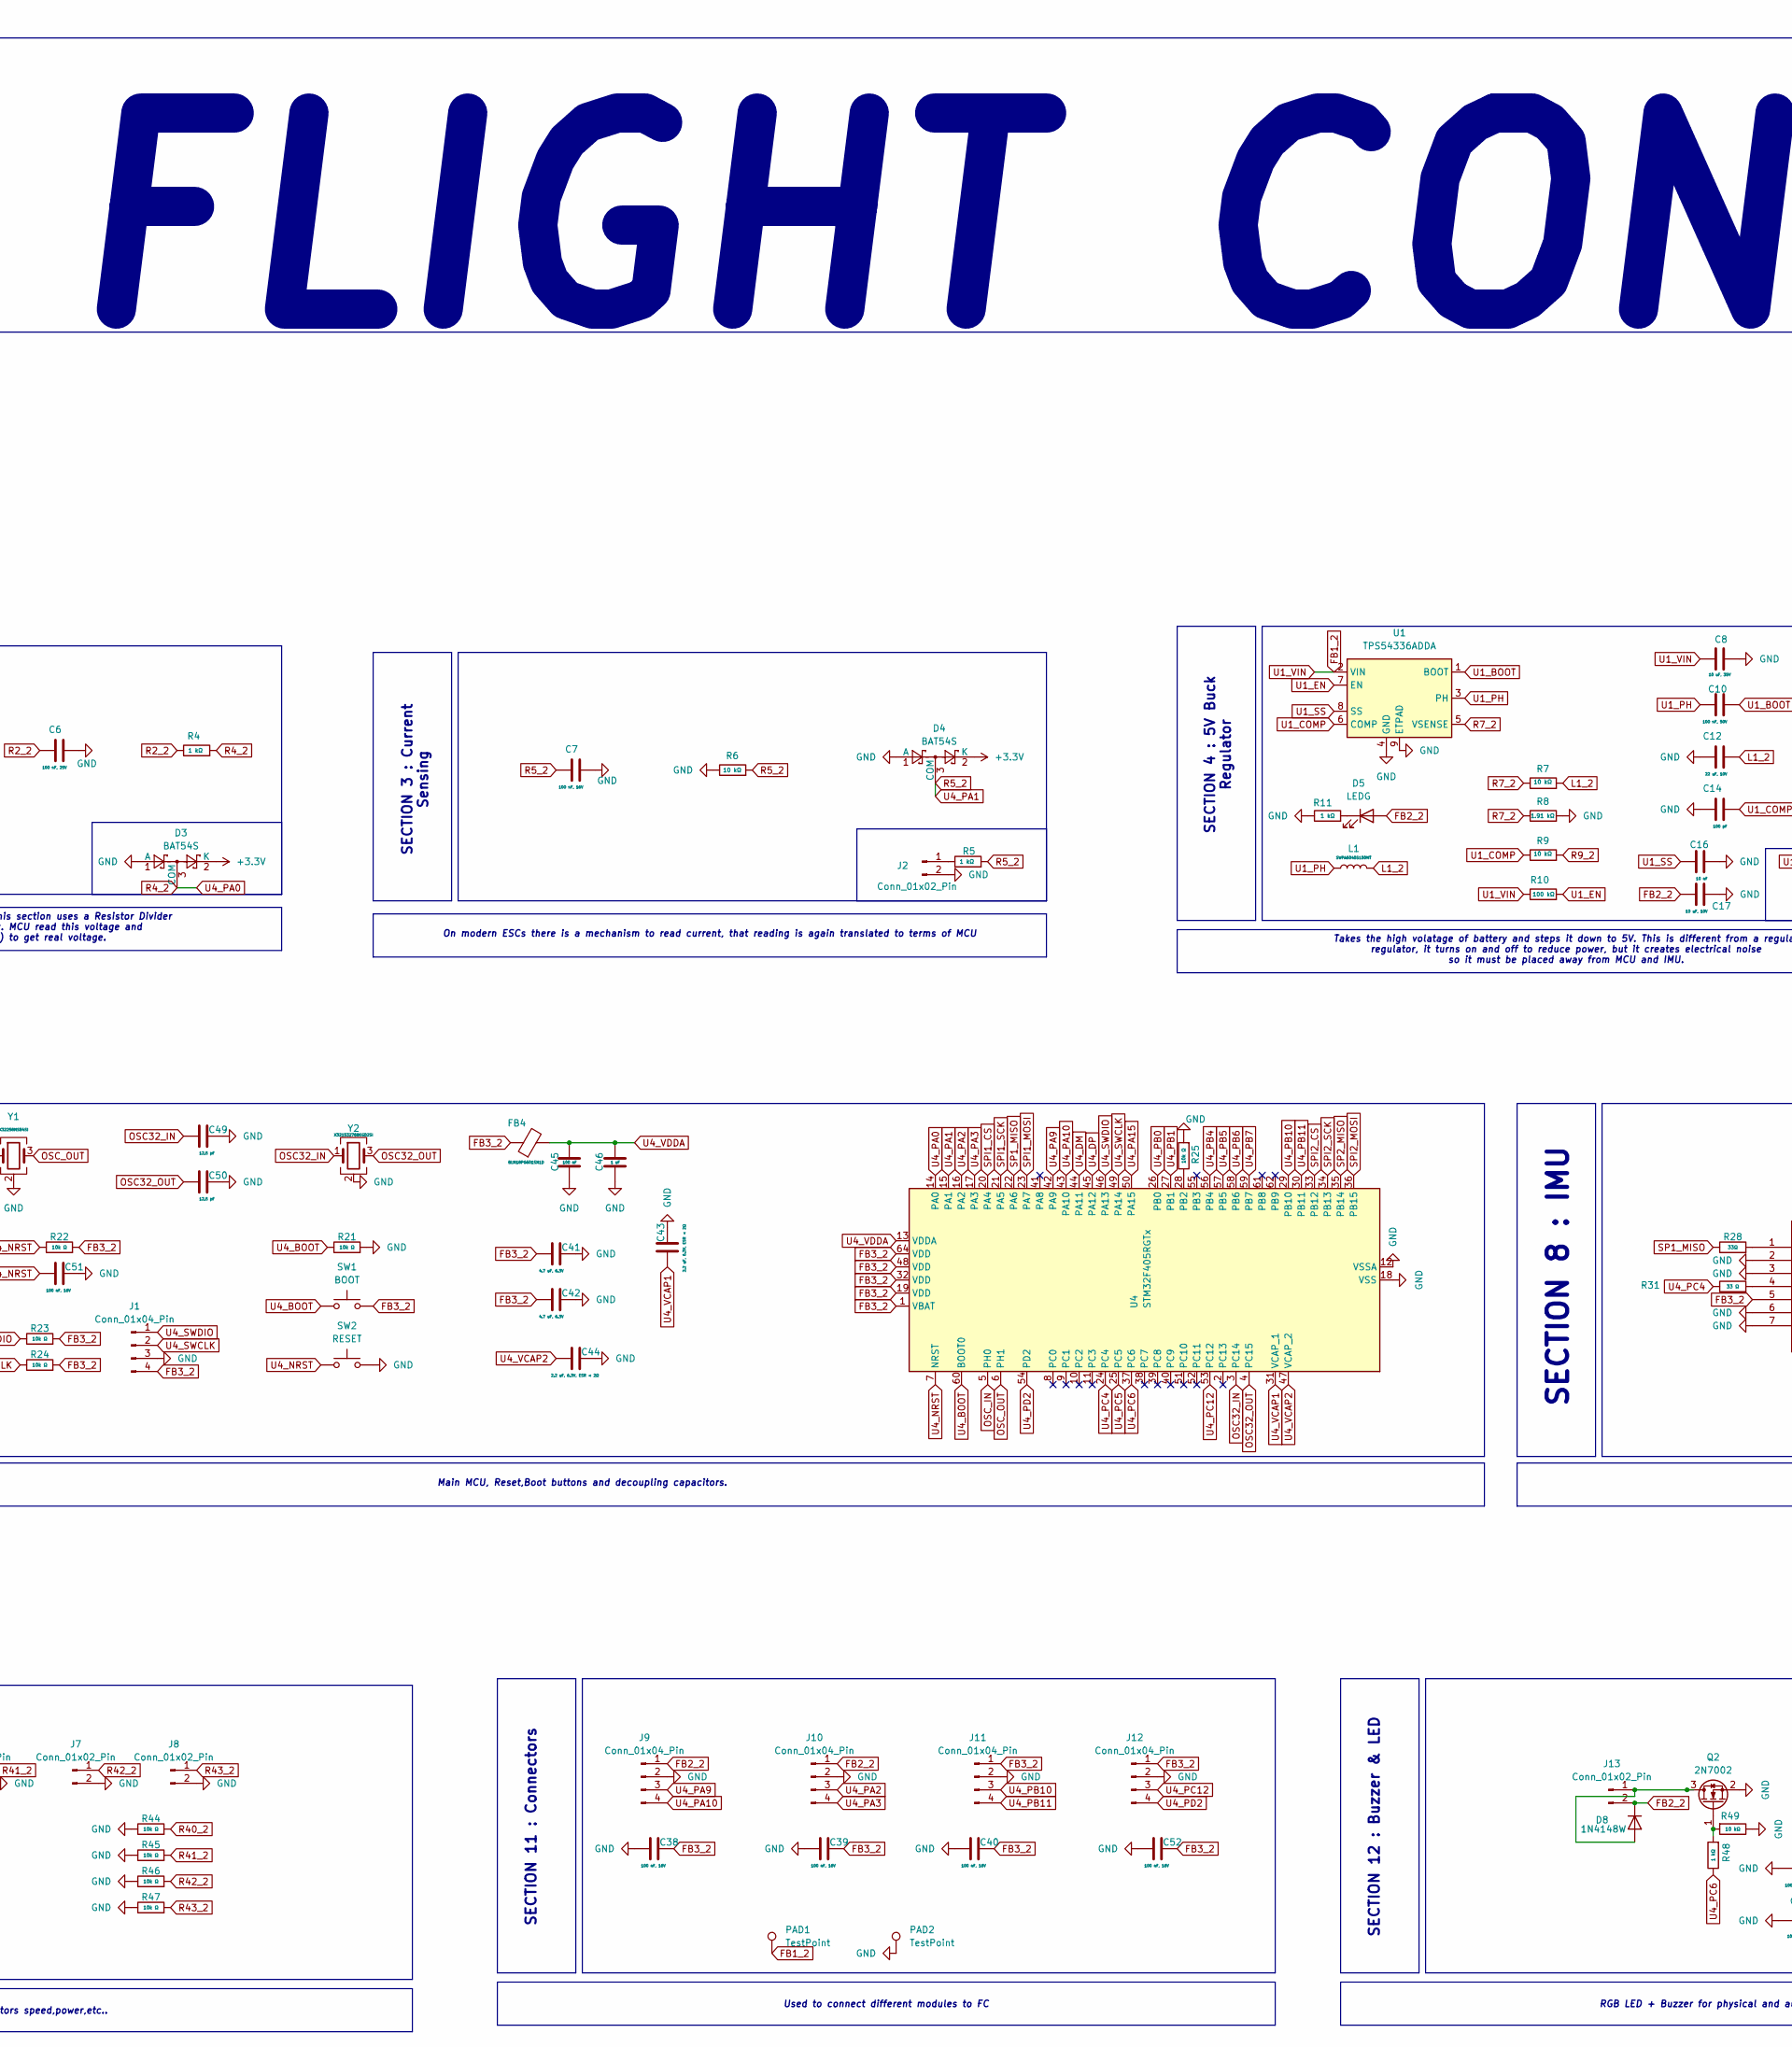
[picture p39: schematic FlightController_Drone.kicad_sch, part in row 1, column 2]

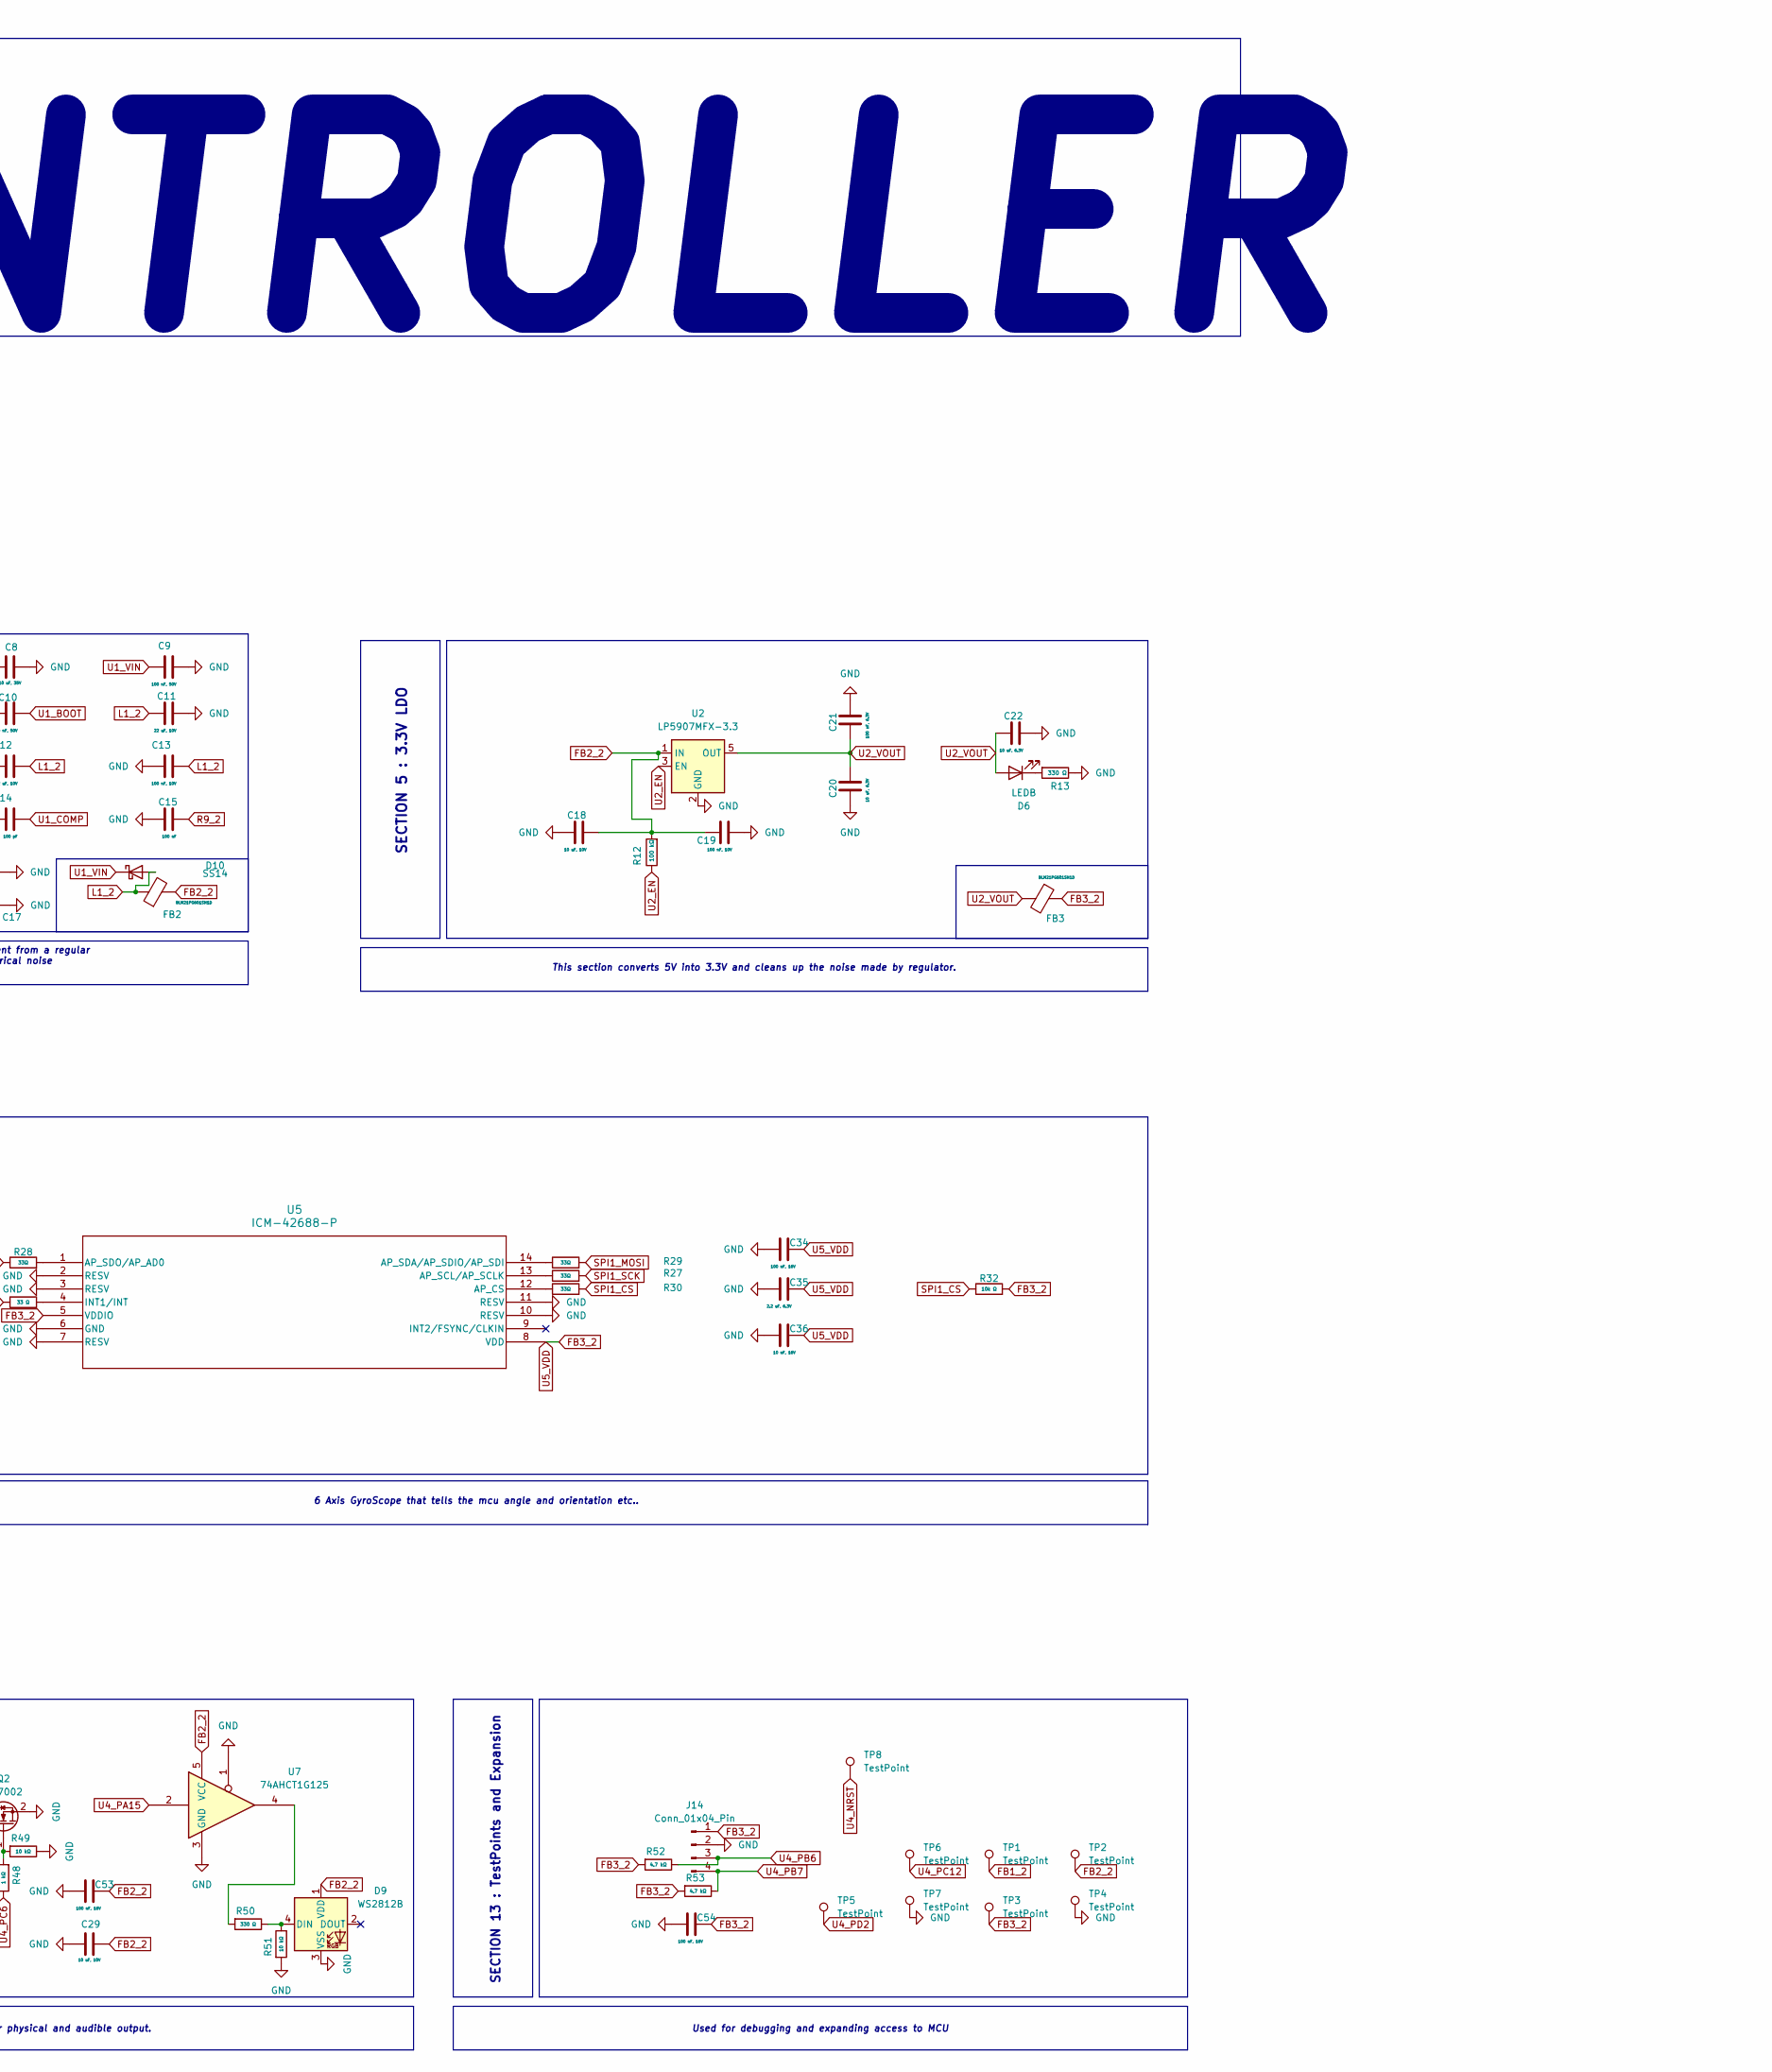
[picture p40: schematic FlightController_Drone.kicad_sch, part in row 1, column 3]

Parts:
C1, C2, C3, C8: 10 uF, 35V; C_1206_3216Metric
C4, C5, C9, C10: 100 nF, 50V; C_0603_1608Metric
C6: 100 nF, 25V; C_0603_1608Metric
C7: 100 nF, 16V; C_0603_1608Metric
C11, C12: 22 uF, 10V; C_0805_2012Metric
C13, C19, C24: 100 nF, 10V; C_0603_1608Metric
C14: 100 pF; C_0603_1608Metric
C15: 100 nF; C_0603_1608Metric
C16: 10 nF; C_0603_1608Metric
C17, C18: 10 uF, 10V; C_0805_2012Metric
C20, C22: 10 uF, 6.3V; C_0805_2012Metric
C21: 100 nF, 6.3V; C_0805_2012Metric
C23: JK-mSMD1206P050TF; C_0603_1608Metric
C25, C26, C27, C28, C34, C37, C38, C39, C40, C51, C52, C53, C54: 100 nF, 16V; C_0402_1005Metric
C29: 10 uF, 10V; C_1206_3216Metric
C35: 2.2 uF, 6.3V; C_0603_1608Metric
C36: 10 nF, 16V; C_0402_1005Metric
C41, C42, C55: 4.7 uF, 6.3V; C_0603_1608Metric
C43, C44: 2.2 uF, 6.3V, ESR < 2Ω; C_0603_1608Metric
C45: 100 nF; C_0402_1005Metric
C46: 1 uF; C_0603_1608Metric
C47, C48: 18 pF; C_0402_1005Metric
C49, C50: 12.5 pF; C_0402_1005Metric
D1: SMBJ28A; D_SMB
D2: BZT52C10; D_SOD-323
D3, D4: BAT54S; SOT-23
D5: LEDG; LED_0603_1608Metric
D6: LEDB; LED_0603_1608Metric
D7, D10: SS14; D_SOD-323
D8: 1N4148W; D_SOD-323
D9: WS2812B; LED_WS2812B_PLCC4_5.0x5.0mm_P3.2mm
F1: JK-mSMD1812P200TF; Fuse_1812_4532Metric
F2: 500 mA; Fuse_1812_4532Metric
FB1, FB2, FB3: BLM21PG601SN1D; L_0805_2012Metric
FB4: BLM18PG601SN1D; L_0805_2012Metric
J1: Conn_01x04_Pin; PinHeader_1x04_P1.27mm_Vertical
J1A1: BAT+; TestPoint_Pad_D3.0mm
J1B1: BAT-; TestPoint_Pad_D3.0mm
J2, J5, J6, J7, J8, J13: Conn_01x02_Pin; PinHeader_1x02_P2.54mm_Vertical
J3: USB_C_Receptacle_USB2.0_16P; USB_C_Receptacle_HCTL_HC-TYPE-C-16P-01A
J9, J10, J11, J12, J14: Conn_01x04_Pin; JST_SH_SM04B-SRSS-TB_1x04-1MP_P1.00mm_Horizontal
L1: SWPA6045S150MT; L_6.3x6.3_H3
PAD1, PAD2: TestPoint; TestPoint_Pad_D2.0mm
Q1: AO3401; SOT-23
Q2: 2N7002; SOT-23
R1, R21, R22, R23, R24, R25, R32, R37, R38, R39, R44, R45, R46, R47: 10k Ω; R_0603_1608Metric
R2, R6, R7, R9, R18, R19: 10 kΩ; R_0603_1608Metric
R3, R4, R5, R11: 1 kΩ; R_0603_1608Metric
R8: 1.91 kΩ; R_0603_1608Metric
R10, R12: 100 kΩ; R_0603_1608Metric
R13: 330 Ω; R_0603_1608Metric
R14, R15: 5.1 kΩ; R_0603_1608Metric
R16, R17: 22Ω; R_0603_1608Metric
R20: 1 MΩ; R_0603_1608Metric
R27, R28, R29, R30, R33, R34, R35, R36, R40, R41, R42, R43: 33Ω; R_0402_1005Metric
R31: 33 Ω; R_0603_1608Metric
R48: 1 kΩ; R_0402_1005Metric
R49, R51: 10 kΩ; R_0402_1005Metric
R50: 330 Ω; R_0402_1005Metric
R52, R53: 4.7 kΩ; R_0402_1005Metric
SW1: BOOT; SW_SPST_TL3342
SW2: RESET; SW_SPST_TL3342
TP1, TP2, TP3, TP4, TP5, TP6, TP7, TP8: TestPoint; TestPoint_Pad_D1.5mm
U1: TPS54336ADDA; TI_SO-PowerPAD-8_ThermalVias
U2: LP5907MFX-3.3; SOT-23-5
U3: USBLC6-2SC6; SOT-23-6
U4: STM32F405RGTx; LQFP-64_10x10mm_P0.5mm
U5: ICM-42688-P; LGA14_2P5X3X0P91_TDK
U6: W25Q128JVS; SOIC-8_5.3x5.3mm_P1.27mm
U7: 74AHCT1G125; SOT-353_SC-70-5
Y1: X32258MSB4SI; Crystal_SMD_3225-4Pin_3.2x2.5mm
Y2: X321532768KGD2SI; Crystal_SMD_3225-4Pin_3.2x2.5mm

Connections:
BAT+: F1.1, J1A1.1 (1_1)
BAT+_F: F1.2, Q1.3 (D)
F2_2: C23.1, D7.2 (A), F2.1, R18.1
FB1_2: C8.1, C9.1, D10.1 (K), FB1.2, PAD1.1 (1_1), R2.1, R10.1, TP1.1 (1_1), U1.2 (VIN)
FB2_2: C17.1, C18.2, C19.1, C29.2, C53.2, D5.2 (A), D7.1 (K), D8.1 (K), D9.1 (VDD), FB2.2, J9.1, J10.1, J13.2, R12.2, TP2.1 (1_1), U2.1 (IN), U7.5 (VCC)
FB3_2: C25.2, C26.2, C27.2, C28.2, C34.2, C35.2, C36.2, C37.1, C38.2, C39.2, C40.2, C41.1, C42.1, C52.2, C54.2, D3.2 (K), D4.2 (K), FB3.1, FB4.1, J1.4, J11.1, J12.1, J14.1, R22.2, R23.2, R24.2, R32.2, R37.2, R38.1, R39.1, R52.2, R53.2, SW1.2, TP3.1 (1_1), U3.5 (VBUS), U4.1 (VBAT), U4.19 (VDD), U4.32 (VDD), U4.48 (VDD), U4.64 (VDD), U5.5 (VDDIO), U5.8 (VDD), U6.8 (VCC)
GND: C1.2, C2.2, C3.2, C4.2, C5.2, C6.2, C7.2, C8.2, C9.2, C11.2, C12.1, C13.1, C14.1, C15.1, C16.2, C17.2, C18.1, C19.2, C20.1, C21.2, C22.2, C23.2, C24.2, C25.1, C26.1, C27.1, C28.1, C29.1, C34.1, C35.1, C36.1, C37.2, C38.1, C39.1, C40.1, C41.2, C42.2, C43.2, C44.2, C45.1, C46.1, C47.2, C48.2, C49.2, C50.2, C51.2, C52.1, C53.1, C54.1, C55.1, D1.2 (A2), D3.1 (A), D4.1 (A), D9.3 (VSS), J1.3, J1B1.1 (1_1), J2.2, J3.A1 (GND), J3.A12 (GND), J3.B1 (GND), J3.B12 (GND), J5.2, J6.2, J7.2, J8.2, J9.2, J10.2, J11.2, J12.2, J14.2, PAD2.1 (1_1), Q2.2 (S), R1.2, R3.2, R6.1, R8.2, R11.1, R13.1, R14.2, R15.2, R19.2, R20.1, R21.2, R25.2, R44.1, R45.1, R46.1, R47.1, R49.1, R51.2, SW2.2, TP4.1 (1_1), TP7.1 (1_1), U1.4 (GND), U1.9 (ETPAD), U2.2 (GND), U3.2 (GND), U4.12 (VSSA), U4.18 (VSS), U4.63 (VSS), U5.2 (RESV), U5.3 (RESV), U5.6 (GND), U5.7 (RESV), U5.10 (RESV), U5.11 (RESV), U6.4 (GND), U7.1, U7.3 (GND), Y1.2 (G), Y1.4 (G), Y2.2 (G), Y2.4 (G)
J3_SH: C55.2, J3.SH (SHIELD), R20.2
J3_VBUS: F2.2, J3.A4 (VBUS), J3.A9 (VBUS), J3.B4 (VBUS), J3.B9 (VBUS)
L1_2: C11.1, C12.2, C13.2, D10.2 (A), FB2.1, L1.2, R7.2
unnamed: D5.1 (K), R11.2
unnamed: D6.1 (K), R13.2
unnamed: D8.2 (A), J13.1, Q2.3 (D)
unnamed: D9.4 (DIN), R50.1, R51.1
unnamed: J2.1, R5.1
unnamed: J3.A5 (CC1), R14.1
unnamed: J3.B5 (CC2), R15.1
unnamed: J3.A6 (D+), J3.B6 (D+), R16.1
unnamed: J3.A7 (D-), J3.B7 (D-), R17.1
unnamed: Q2.1 (G), R48.2, R49.2
unnamed: R50.2, U7.4
unnamed: R25.1, U4.28 (PB2)
unnamed: R30.1, U5.12 (AP_CS)
unnamed: R27.1, U5.13 (AP_SCL/AP_SCLK)
unnamed: R29.1, U5.14 (AP_SDA/AP_SDIO/AP_SDI)
unnamed: R28.2, U5.1 (AP_SDO/AP_AD0)
unnamed: R31.2, U5.4 (INT1/INT)
unnamed: R33.2, U6.6 (CLK)
unnamed: R34.2, U6.5 (DI/IO_{0})
unnamed: R35.2, U6.2 (DO/IO_{1})
unnamed: R36.2, U6.1 (~CS)
unnamed: R39.2, U6.7 (~HOLD/~RESET/IO_{3})
unnamed: R38.2, U6.3 (~WP/IO_{2})
OSC32_IN: C49.1, U4.3 (PC14), Y2.1
OSC32_OUT: C50.1, U4.4 (PC15), Y2.3
OSC_IN: C47.1, U4.5 (PH0), Y1.1
OSC_OUT: C48.1, U4.6 (PH1), Y1.3
Q1_D: C1.1, C2.1, C3.1, C4.1, C5.1, D1.1 (A1), D2.1 (K), FB1.1, Q1.2 (S)
Q1_GATE: D2.2 (A), Q1.1 (G), R1.1
R2_2: C6.1, R2.2, R3.1, R4.1
R4_2: D3.3 (COM), R4.2, U4.14 (PA0)
R5_2: C7.1, D4.3 (COM), R5.2, R6.2, U4.15 (PA1)
R7_2: R7.1, R8.1, U1.5 (VSENSE)
R9_2: C15.2, R9.2
R16_2: R16.2, U3.1 (I/O1), U4.45 (PA12)
R17_2: R17.2, U3.3 (I/O2), U4.44 (PA11)
R40_2: J5.1, R40.2, R44.2
R41_2: J6.1, R41.2, R45.2
R42_2: J7.1, R42.2, R46.2
R43_2: J8.1, R43.2, R47.2
SP1_MISO: R28.1, U4.22 (PA6)
SP2_MISO: R35.1, U4.35 (PB14)
SPI1_CS: R30.2, R32.1, U4.20 (PA4)
SPI1_MOSI: R29.2, U4.23 (PA7)
SPI1_SCK: R27.2, U4.21 (PA5)
SPI2_CS: R36.1, R37.1, U4.33 (PB12)
SPI2_MOSI: R34.1, U4.36 (PB15)
SPI2_SCK: R33.1, U4.34 (PB13)
U1_BOOT: C10.2, U1.1 (BOOT)
U1_COMP: C14.2, R9.1, U1.6 (COMP)
U1_EN: R10.2, U1.7 (EN)
U1_PH: C10.1, L1.1, U1.3 (PH)
U1_SS: C16.1, U1.8 (SS)
U2_EN: R12.1, U2.3 (EN)
U2_VOUT: C20.2, C21.1, C22.1, D6.2 (A), FB3.2, U2.5 (OUT)
U4_BOOT: R21.1, SW1.1, U4.60 (BOOT0)
U4_NRST: C51.1, R22.1, SW2.1, TP8.1, U4.7 (NRST)
U4_PA2: J10.3, U4.16 (PA2)
U4_PA3: J10.4, U4.17 (PA3)
U4_PA9: J9.3, U4.42 (PA9)
U4_PA10: J9.4, U4.43 (PA10)
U4_PA15: U4.50 (PA15), U7.2
U4_PB0: R42.1, U4.26 (PB0)
U4_PB1: R43.1, U4.27 (PB1)
U4_PB4: R40.1, U4.56 (PB4)
U4_PB5: R41.1, U4.57 (PB5)
U4_PB6: J14.3, R52.1, U4.58 (PB6)
U4_PB7: J14.4, R53.1, U4.59 (PB7)
U4_PB10: J11.3, U4.29 (PB10)
U4_PB11: J11.4, U4.30 (PB11)
U4_PC4: R31.1, U4.24 (PC4)
U4_PC5: C24.1, R18.2, R19.1, U4.25 (PC5)
U4_PC6: R48.1, U4.37 (PC6)
U4_PC12: J12.3, TP6.1 (1_1), U4.53 (PC12)
U4_PD2: J12.4, TP5.1 (1_1), U4.54 (PD2)
U4_SWCLK: J1.2, R24.1, U4.49 (PA14)
U4_SWDIO: J1.1, R23.1, U4.46 (PA13)
U4_VCAP1: C43.1, U4.31 (VCAP_1)
U4_VCAP2: C44.1, U4.47 (VCAP_2)
U4_VDDA: C45.2, C46.2, FB4.2, U4.13 (VDDA)

Notes on the sheet:
SECTION 6 : USB OR-ING
SECTION 12 : Buzzer & LED
SECTION 4 : 5V Buck Regulator
SECTION 1 : Power Input & Protection
CUSTOM FLIGHT CONTROLLER
SECTION 3 : Current Sensing
SECTION 8 : IMU
SECTION 10 : Motors
SECTION 7 : MCU Core
SECTION 9 : Blackbox Flash
SECTION 2 : VBAT Voltage Sensing
SECTION 11 : Connectors
SECTION 5 : 3.3V LDO
Details
SECTION 13 : TestPoints and Expansion
Main MCU, Reset,Boot buttons and decoupling capacitors.
Helps to flash firmaware for MCU and prevents battery and USB pushing power into each other
In simple version MCU can read in terms of 3.3v and this section uses a Resistor Divider and reduces the High voltage from a battery pack. MCU read this voltage and multiplies with a specific number (here 11) to get real voltage.
This section receives the power directly from the battery. It serves it purpose of Fuseing it (protection against shorts) and also uses Mosfet to protect from reverse battery connections and provides safe output from FB1 but still its dangerous.
6 Axis GyroScope that tells the mcu angle and orientation etc..
This section converts 5V into 3.3V and cleans up the noise made by regulator.
Takes the high volatage of battery and steps it down to 5V. This is different from a regular regulator, it turns on and off to reduce power, but it creates electrical noise so it must be placed away from MCU and IMU.
Used to connect different modules to FC
Stores data,logs etc.
Author : Hemanth YSWS : Pixl
On modern ESCs there is a mechanism to read current, that reading is again translated to terms of MCU
Controls motors speed,power,etc..
RGB LED + Buzzer for physical and audible output.
Used for debugging and expanding access to MCU

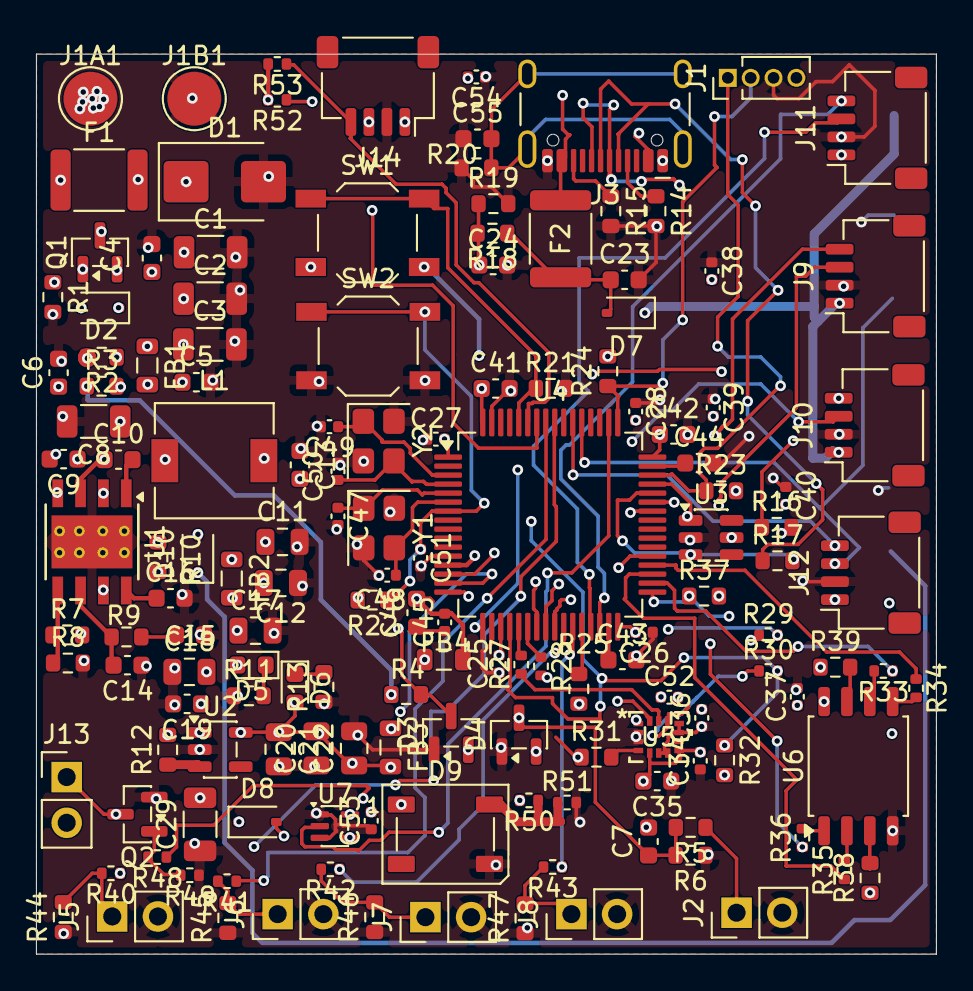
[picture p41: board FlightController_Drone.kicad_pcb from above]

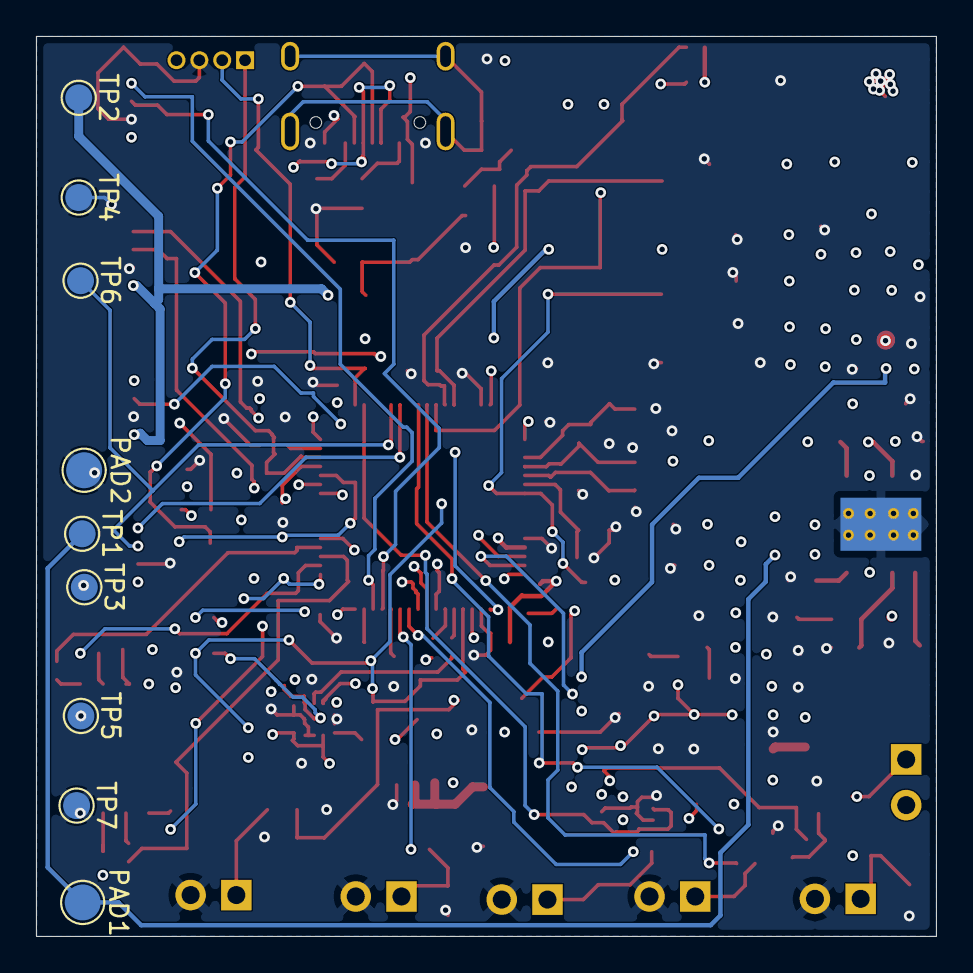
[picture p42: board FlightController_Drone.kicad_pcb from below]

Board: 4 copper layers, 50.0 x 50.0 mm, 157 parts (9 on the bottom side), 90 nets.
