damnitzhemanth-oss/Flight_Controller/(commit log)

2026-10-12 Final ReadME
    [FlightController_Drone.csv, FlightController_Drone.kicad_pcb, FlightController_Drone.kicad_sch]
2026-10-13 added POS
    [FlightController_Drone-all-pos.csv]
2026-10-13 added cad files
    [FlightController_Drone.step]
